bugg-resources/bugg-enclosure/README.md

# bugg-enclosure

This repository contains the FreeCAD source files for the full mechanical assembly of the Bugg recording device. This includes the custom injection moulded inclosure, as well as all connectors, fasteners, etc. used.

For a full overview of the design of the Bugg recording device and practical assembly instructions please refer to the [Bugg hardware handover document](https://raw.githubusercontent.com/bugg-resources/bugg-handover/master/bugg-handover.pdf).

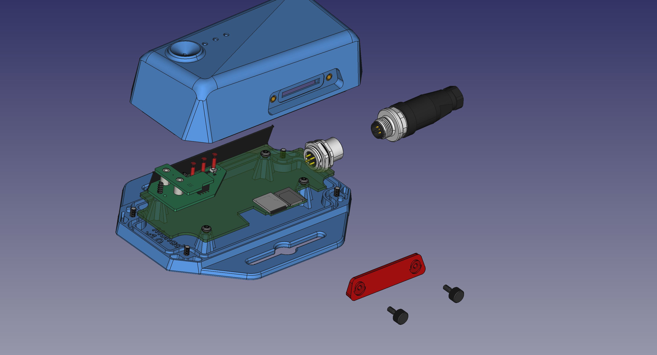
[picture p1: sp-enclosure/cad/exports/1.0/scene-v1.0-2.png]
Bugg exploded view
