bugg-resources/bugg-enclosure/cad/exports/0.15/scene-2.png

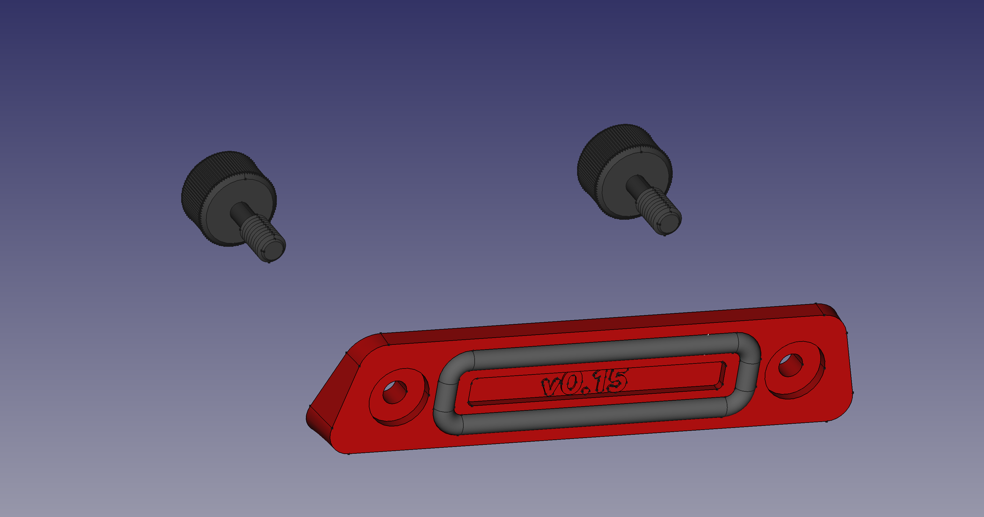
cad/exports/0.15/scene-2.png
