bugg-resources/bugg-enclosure/cad/exports/0.15/scene-3.png

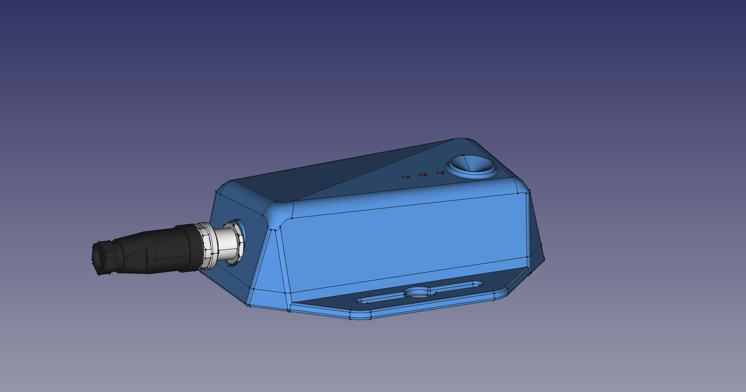
cad/exports/0.15/scene-3.png
