bugg-resources/bugg-enclosure/cad/exports/0.16/scene-1.png

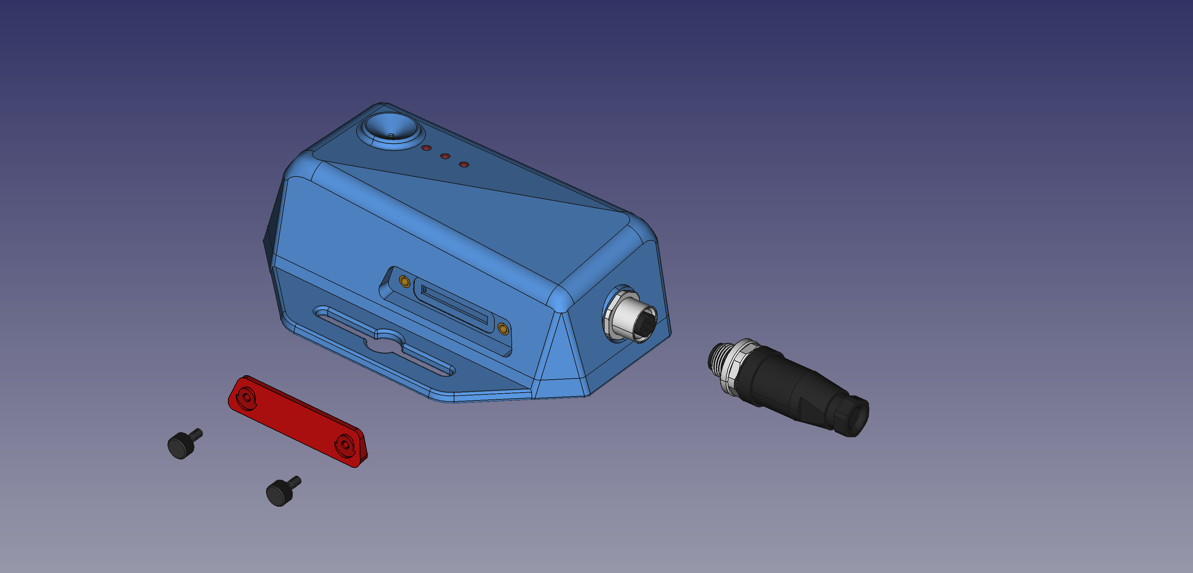
cad/exports/0.16/scene-1.png
