bugg-resources/bugg-enclosure/cad/exports/0.16/scene-2.png

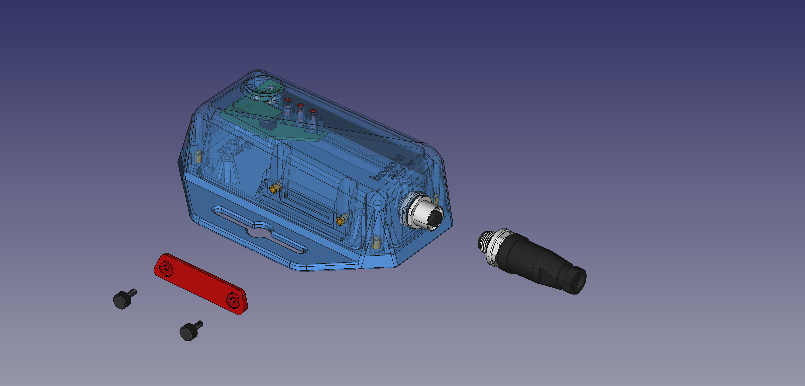
cad/exports/0.16/scene-2.png
