bugg-resources/bugg-enclosure/cad/exports/0.16/scene-3.png

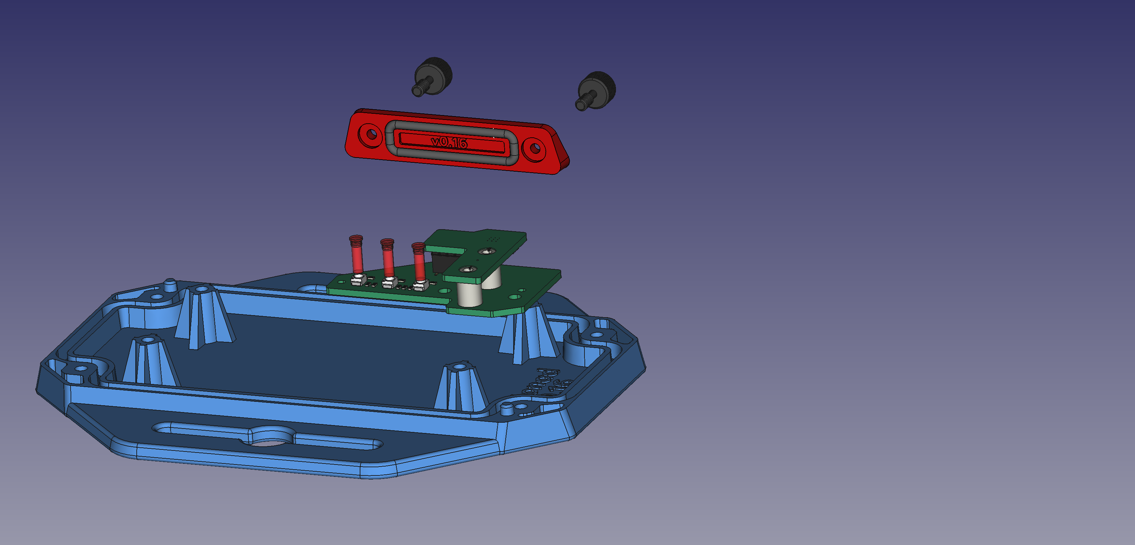
cad/exports/0.16/scene-3.png
