bugg-resources/bugg-enclosure/cad/exports/0.16/scene-4.png

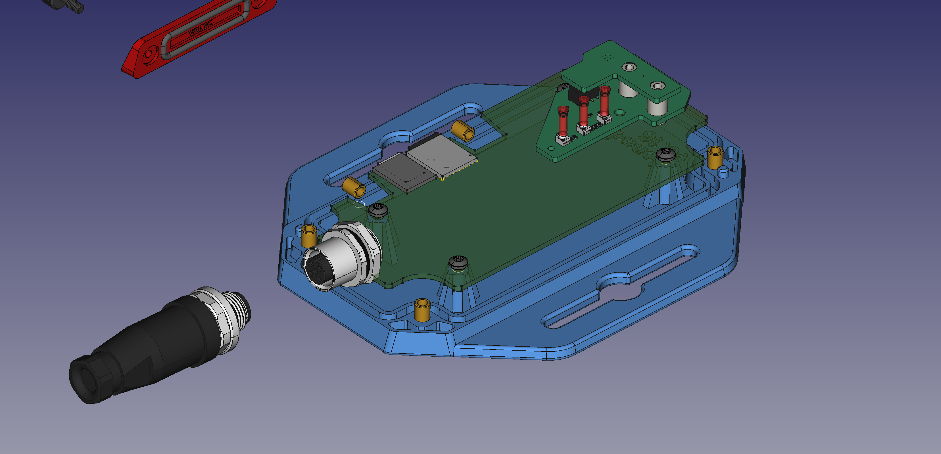
cad/exports/0.16/scene-4.png
