bugg-resources/bugg-enclosure/cad/exports/1.0/scene-v1.0-1.png

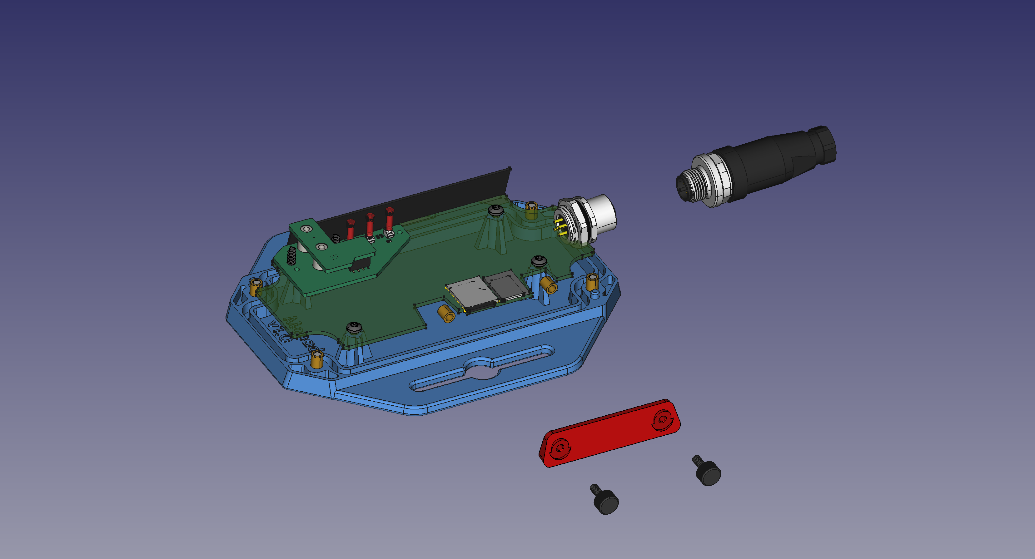
cad/exports/1.0/scene-v1.0-1.png
