bugg-resources/bugg-enclosure/cad/exports/1.2/inspection-difference-v1.0-v1.2.png

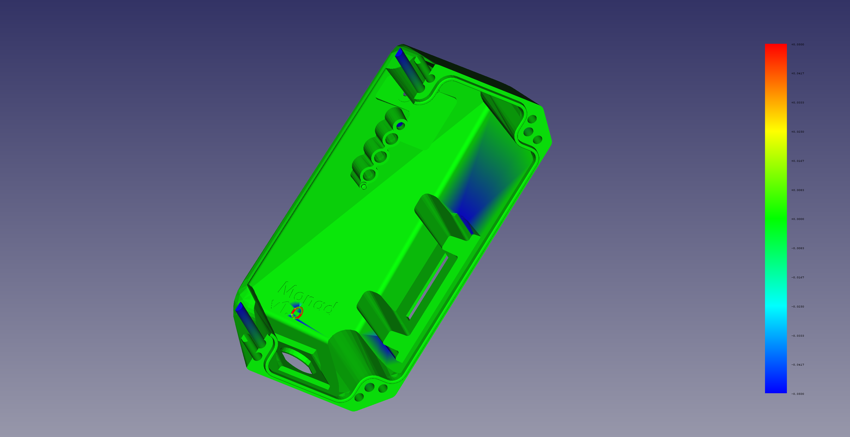
cad/exports/1.2/inspection-difference-v1.0-v1.2.png
