bugg-resources/bugg-enclosure/cad/exports/1.4/inspection-base-corner-closeup.png

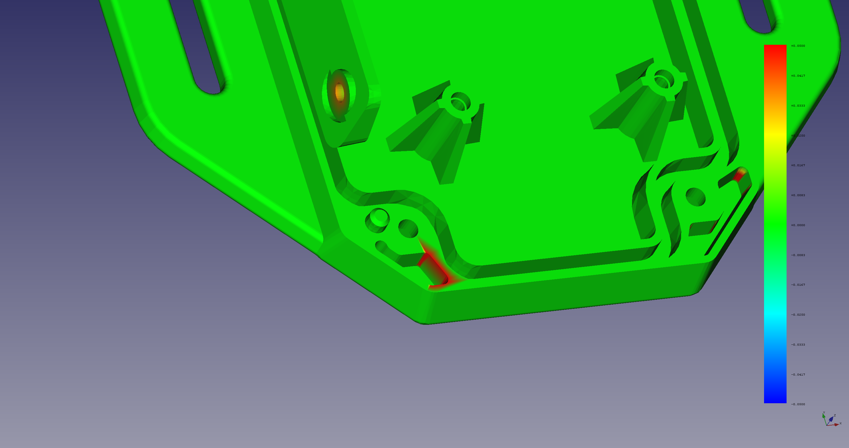
cad/exports/1.4/inspection-base-corner-closeup.png
