bugg-resources/bugg-enclosure/cad/exports/1.4/inspection-base-top-view.png

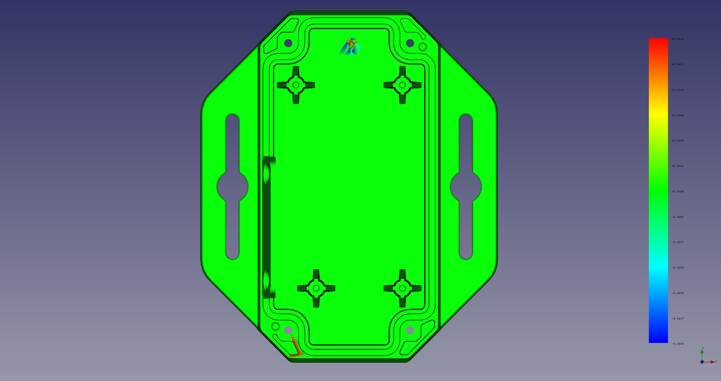
cad/exports/1.4/inspection-base-top-view.png
