bugg-resources/bugg-enclosure/cad/exports/1.4/inspection-lid-inside-view.png

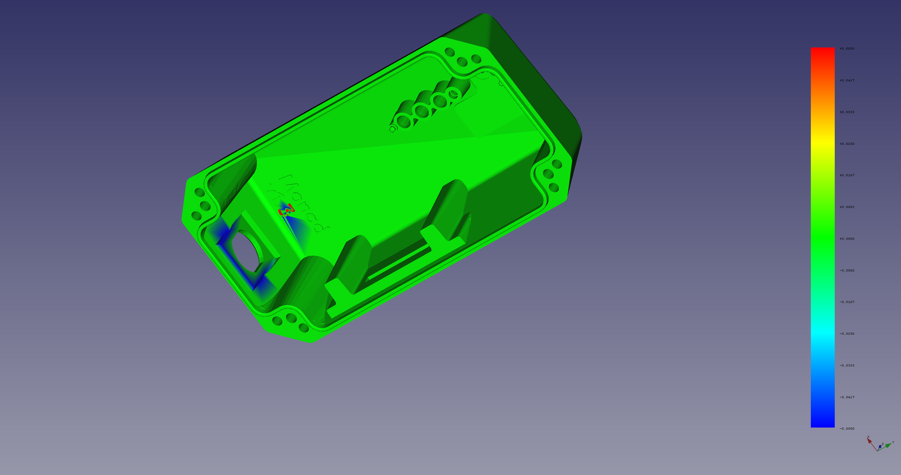
cad/exports/1.4/inspection-lid-inside-view.png
