bugg-resources/bugg-enclosure/cad/exports/1.4/inspection-side-view-closeup.png

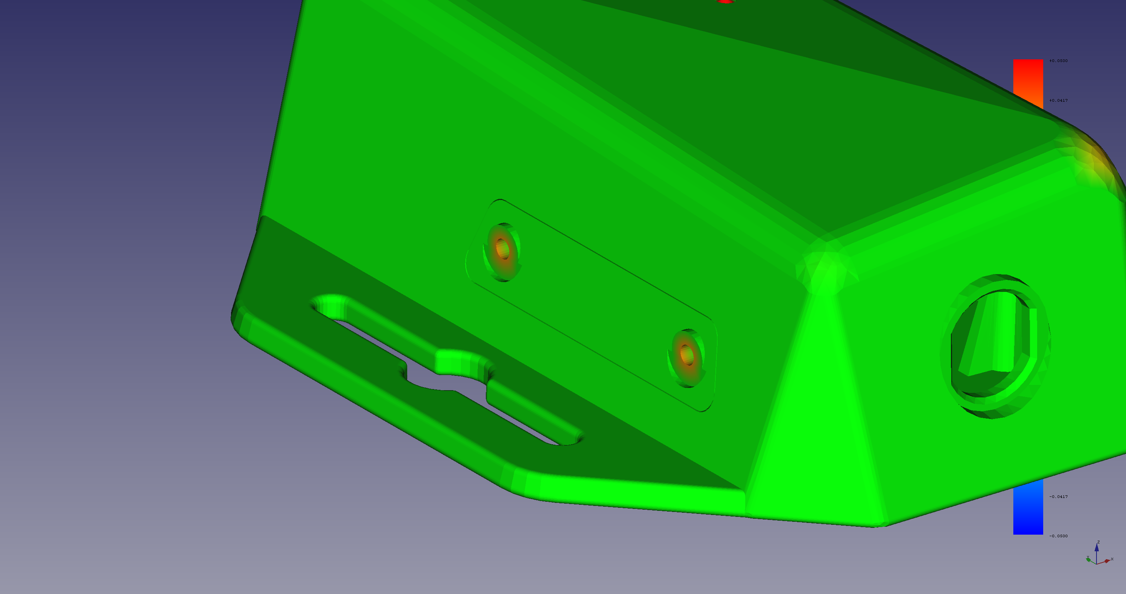
cad/exports/1.4/inspection-side-view-closeup.png
