bugg-resources/bugg-enclosure/cad/exports/1.4/inspection-top-view-closeup.png

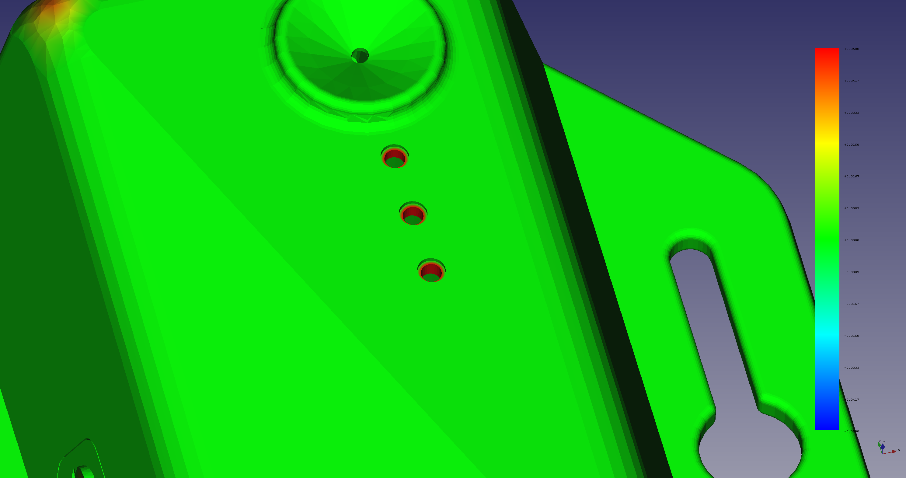
cad/exports/1.4/inspection-top-view-closeup.png
