bugg-resources/bugg-enclosure/cad/exports/1.4/inspection-top-view.png

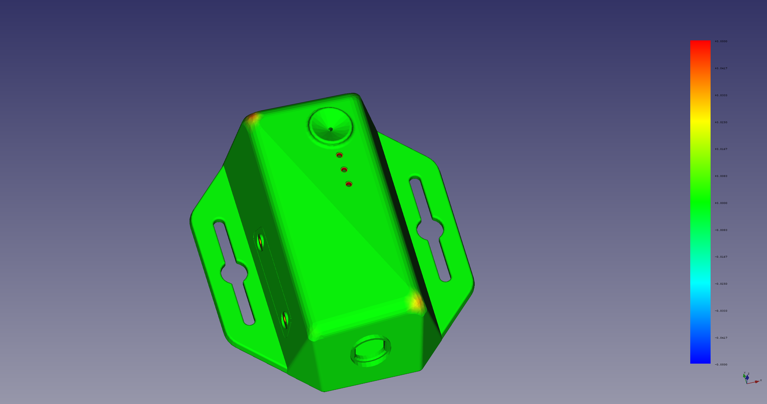
cad/exports/1.4/inspection-top-view.png
