bugg-resources/bugg-enclosure/cad/exports/1.5/enclosure-base-surface-finish-bottom-view.png

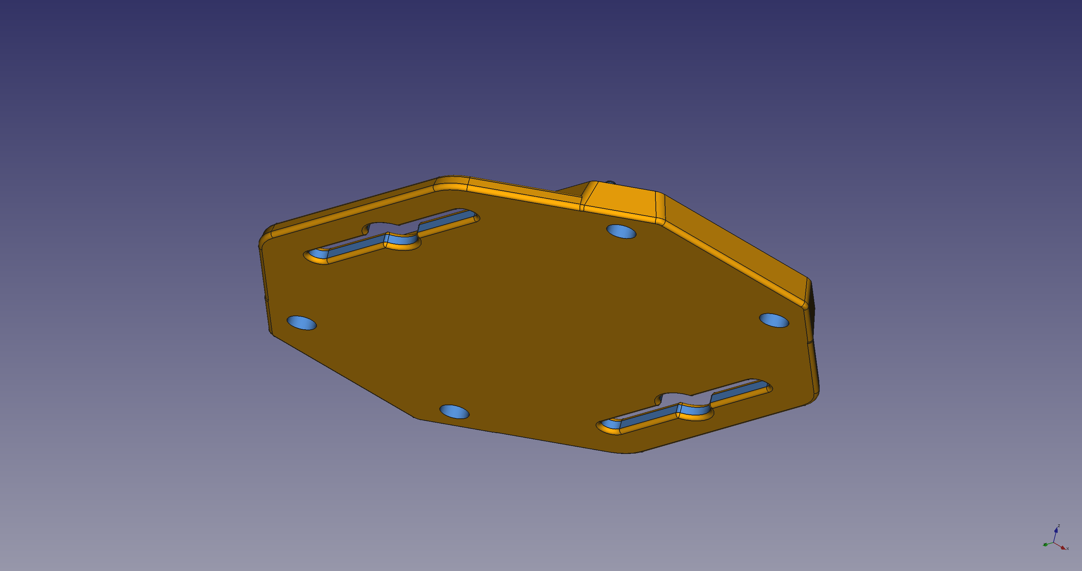
cad/exports/1.5/enclosure-base-surface-finish-bottom-view.png
