bugg-resources/bugg-enclosure/cad/exports/1.5/enclosure-lid-inserts.jpeg

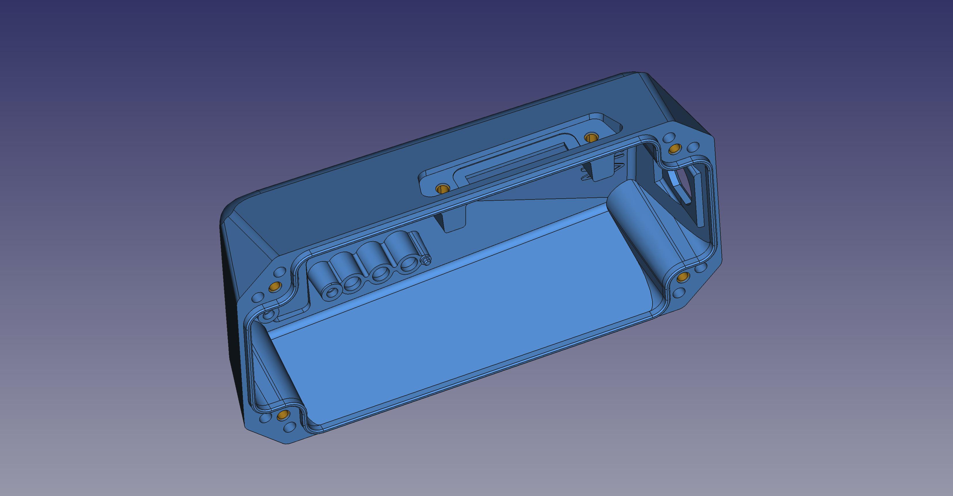
cad/exports/1.5/enclosure-lid-inserts.jpeg
