bugg-resources/bugg-enclosure/cad/exports/FIP/FIPFG-base-groove.png

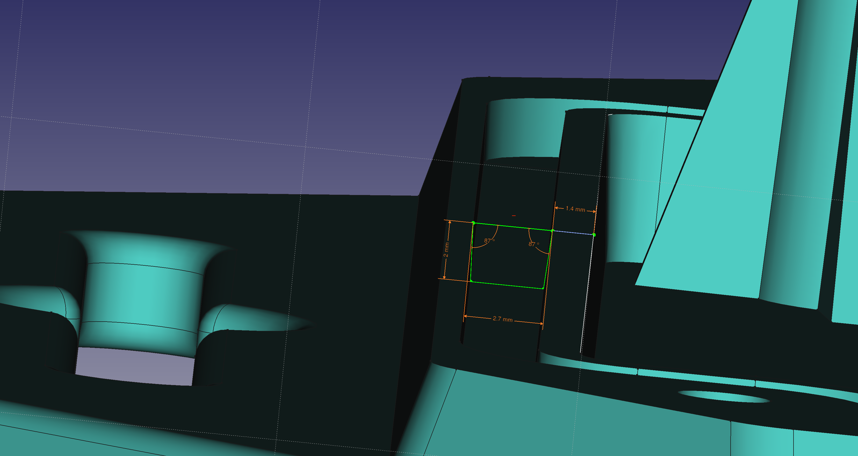
cad/exports/FIP/FIPFG-base-groove.png
