bugg-resources/bugg-enclosure/cad/exports/FIP/FIPFG-door-seated.png

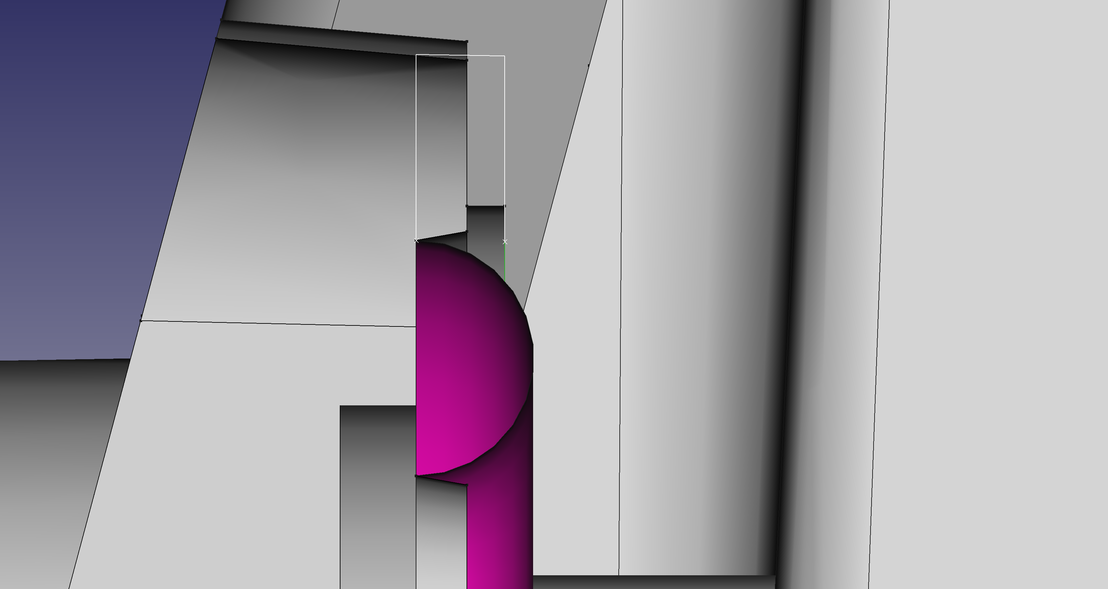
cad/exports/FIP/FIPFG-door-seated.png
