bugg-resources/bugg-enclosure/cad/exports/FIP/FIPFG-door.png

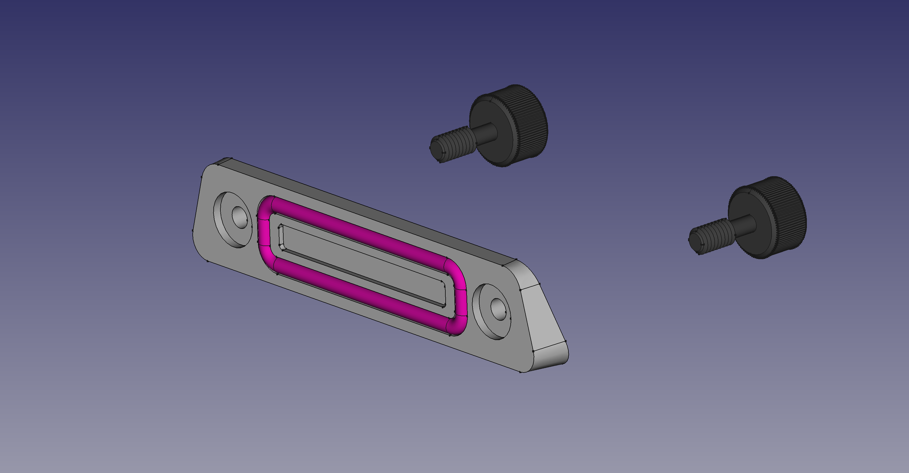
cad/exports/FIP/FIPFG-door.png
