bugg-resources/bugg-enclosure/cad/exports/FIP/FIPFG-lid-seated.png

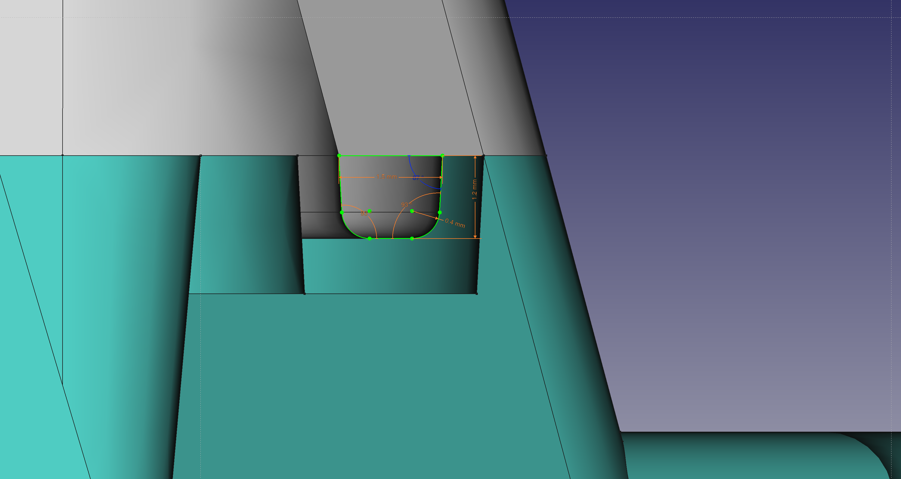
cad/exports/FIP/FIPFG-lid-seated.png
