bugg-resources/bugg-enclosure/cad/exports/FIP/FIPFG-lid-tongue.png

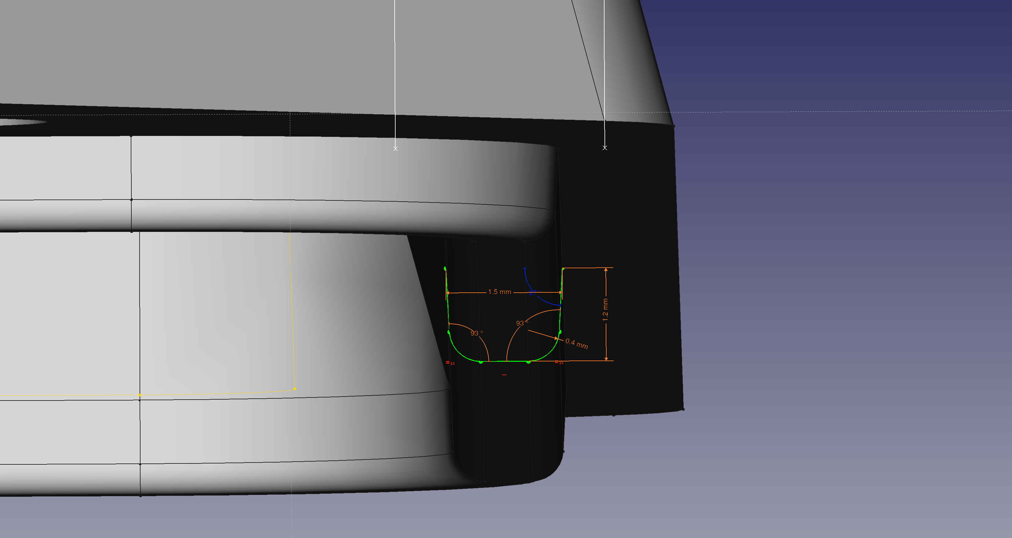
cad/exports/FIP/FIPFG-lid-tongue.png
