bugg-resources/bugg-enclosure/cad/pcba-main.FCStd

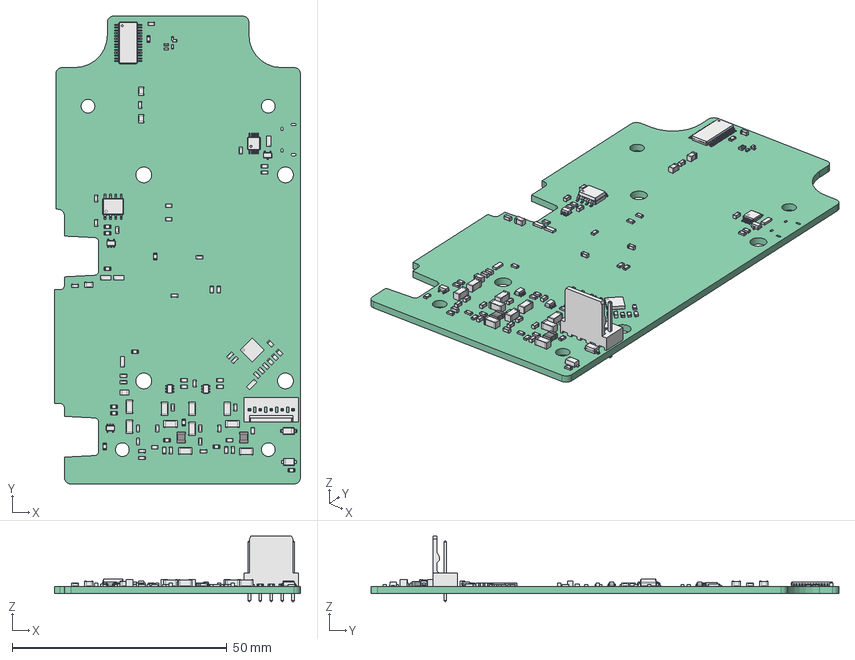
[picture p28: CAD file, 2022-12-02]
cad/pcba-main.FCStd
57.3 x 109.0 x 15.3 mm
Pcb_8c84
C36_C_0603_1608Metric_71721f83c2b1 x 29
C23_C_0805_2012Metric_b6db5c6b0151 x 4
R7_R_0603_1608Metric_90bd1c2a9cc0 x 33
D4_D_SOD_123_dbecf328b756
U13_SOIC_8_39x49mm_P127mm_c0191ea9d7d9
C43_C_1206_3216Metric_21374b62ed42 x 10
Q4_SOT_323_SC_70_d6f08c28aa3d
U8_USON_10_25x10mm_Pitch05mm_80e52ca13184 x 5
R20_R_0402_1005Metric_2000e09633fa x 3
U15_MSOP_10_3x3mm_P05mm_e307f94544ba
U12_QFN-24-1EP_4x4mm_Pitch0.5mm_dd8f22cad111
C20_C_0402_1005Metric_a572c28d08b5 x 2
J10_Molex_AE_6410_05A_f7ff2170b38e
FB1_L_1008_2520Metric_feb8b3634ed0 x 2
U14_SOT_353_SC_70_5_8718e2f7add4 x 2
D5_D_SOD_123F_94f546b71baf
U17_TSSOP_28_44x97mm_P065mm_d82abc36541a
U3_SOT_363_SC_70_6_186d3005d5da x 2
