bugg-resources/bugg-enclosure/cad/exports/0.8/enclosure-assy-v0.8.step

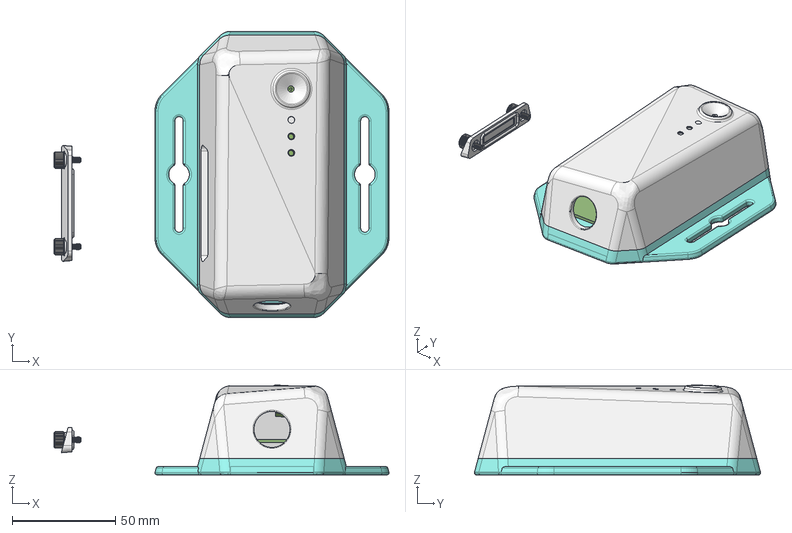
[picture p29: CAD file, 2021-01-20]
cad/exports/0.8/enclosure-assy-v0.8.step
162.3 x 138.7 x 43.5 mm
enclosure-base
enclosure-lid
pcb-main
enclosure-door
antenna-2JP0624P
nanoSIM
SF72-nano-sim-slot
ST11-H
microSD
P0161.030-008-B2
P0161.030-008-B003
pcb-mic
pcb-leds
