bugg-resources/bugg-enclosure/cad/exports/0.10/enclosure-door-v0.10.step

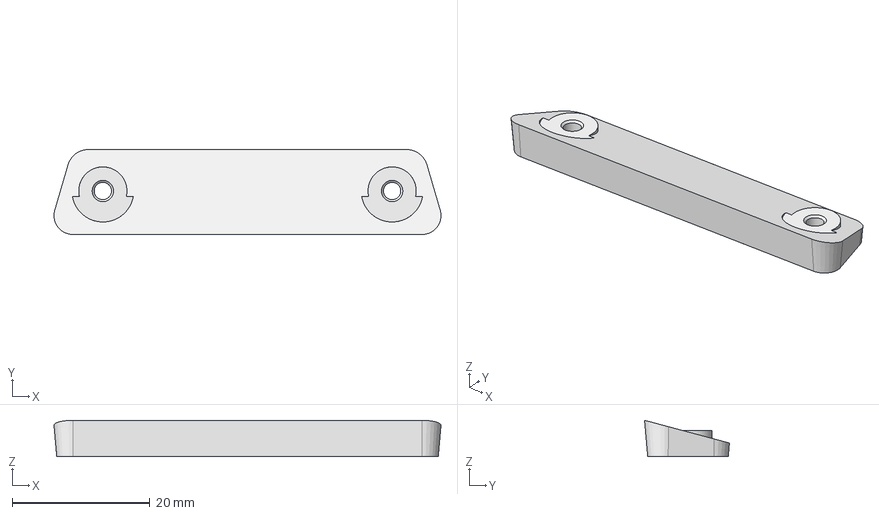
[picture p30: CAD file, 2021-02-13]
cad/exports/0.10/enclosure-door-v0.10.step
56.2 x 12.3 x 5.28 mm
