bugg-resources/bugg-enclosure/cad/exports/0.13.1/enclosure-base-v0.13.1.step

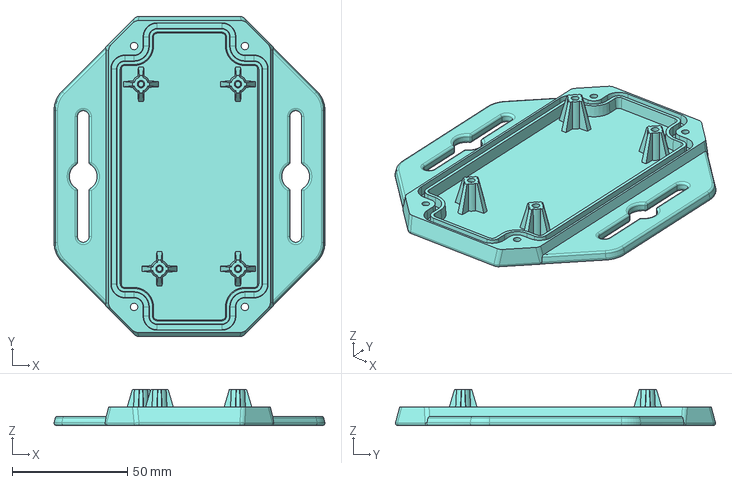
[picture p32: CAD file, 2021-02-22]
cad/exports/0.13.1/enclosure-base-v0.13.1.step
117.4 x 138.7 x 15.6 mm
