bugg-resources/bugg-enclosure/cad/exports/0.15/enclosure-base-v0.15.step

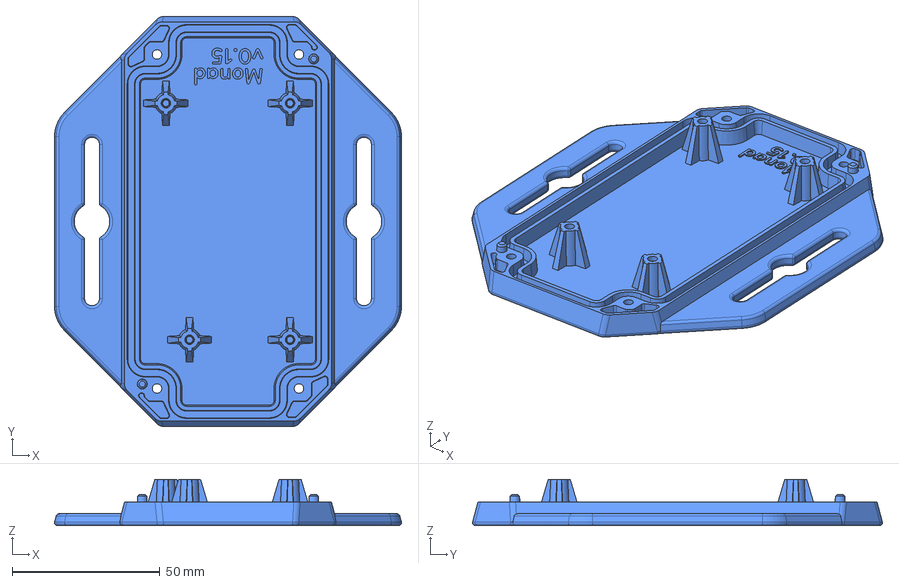
[picture p33: CAD file, 2021-02-24]
cad/exports/0.15/enclosure-base-v0.15.step
117.4 x 138.7 x 15.6 mm
