bugg-resources/bugg-enclosure/cad/exports/0.7/enclosure-door-v0.7.step

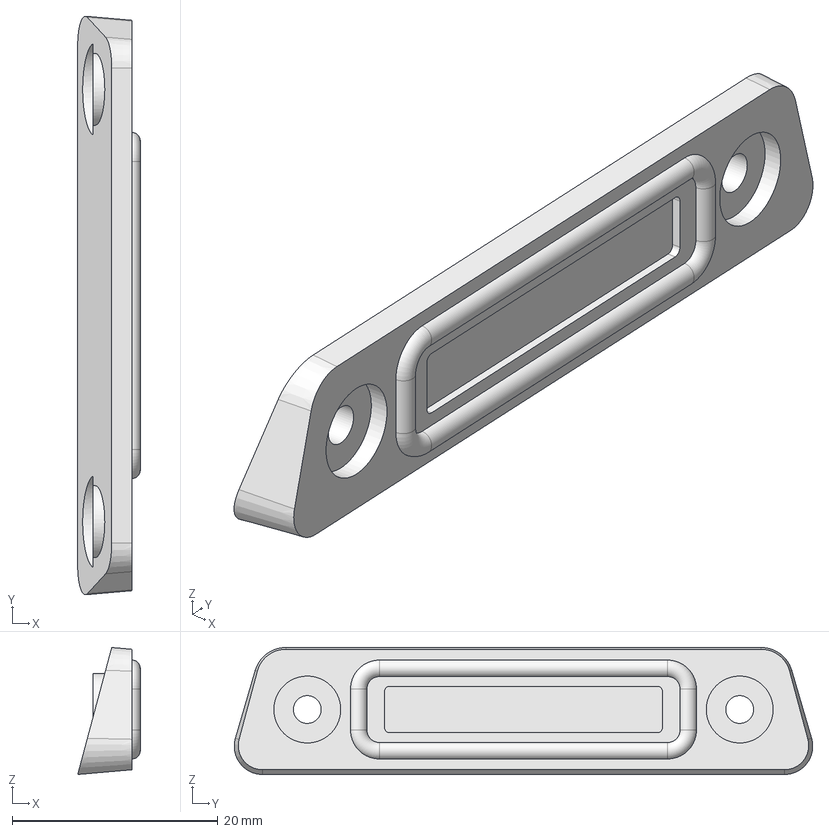
[picture p34: CAD file, 2021-01-20]
cad/exports/0.7/enclosure-door-v0.7.step
6.08 x 56.2 x 12.3 mm
