bugg-resources/bugg-enclosure/cad/exports/1.0/PL_enclosure-lid-v1.0.stp

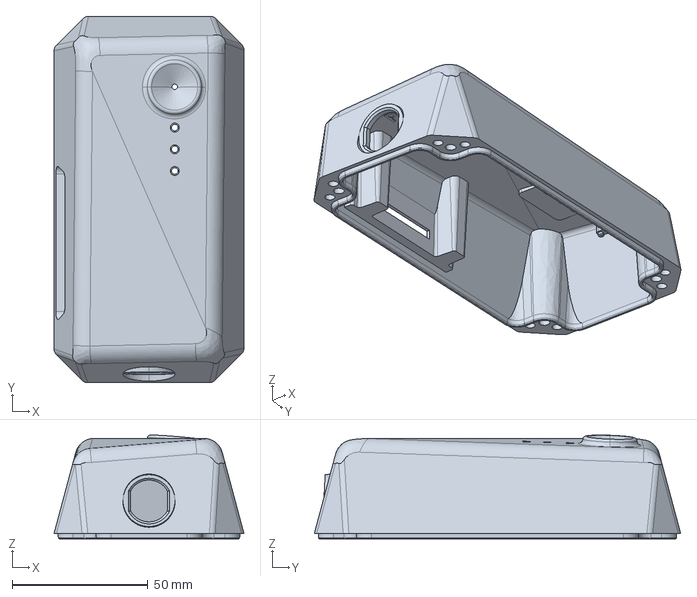
[picture p37: CAD file, 2021-03-11]
cad/exports/1.0/PL_enclosure-lid-v1.0.stp
70.0 x 135.0 x 38.3 mm
