bugg-resources/bugg-enclosure/cad/exports/1.5/insert-tappex-001m3.step

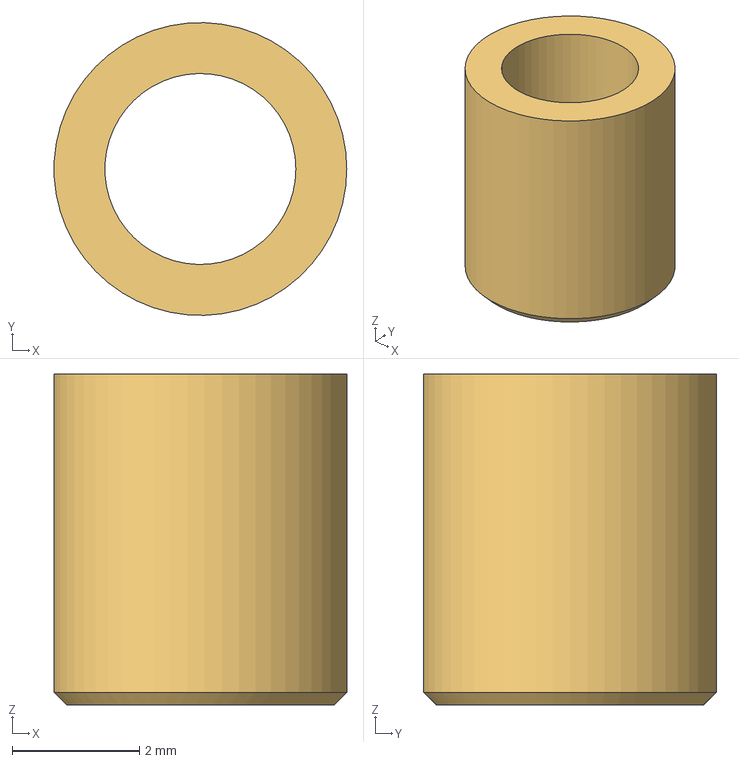
[picture p38: CAD file, 2023-03-03]
cad/exports/1.5/insert-tappex-001m3.step
4.60 x 4.60 x 5.20 mm
