bugg-resources/bugg-enclosure/cad/insert-tappex-002m3.FCStd

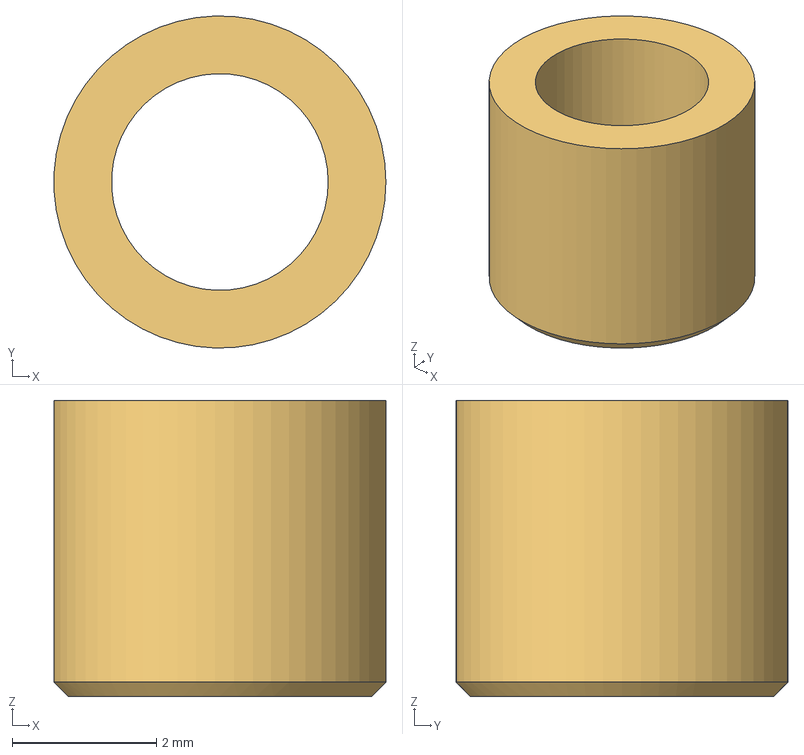
[picture p39: CAD file, 2022-12-02]
cad/insert-tappex-002m3.FCStd
4.60 x 4.60 x 4.10 mm
