bugg-resources/bugg-enclosure/sp-enclosure/cad/enclosure-faceted3.FCStd

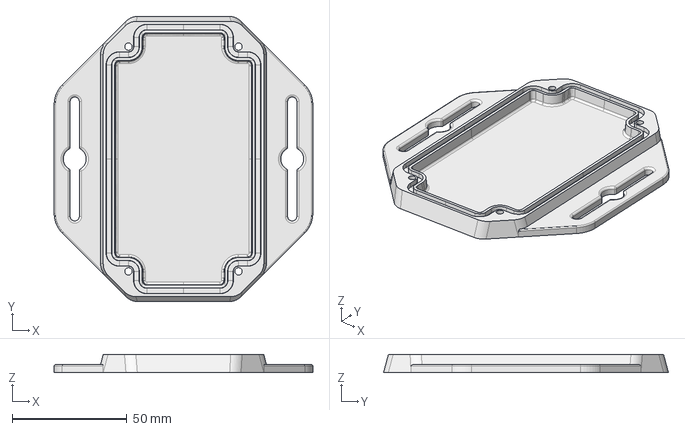
[picture p40: CAD file, 2020-12-04]
sp-enclosure/cad/enclosure-faceted3.FCStd
112.8 x 124.3 x 8.00 mm
