bugg-resources/bugg-enclosure/cad/exports/0.10/enclosure-base-v0.10.step

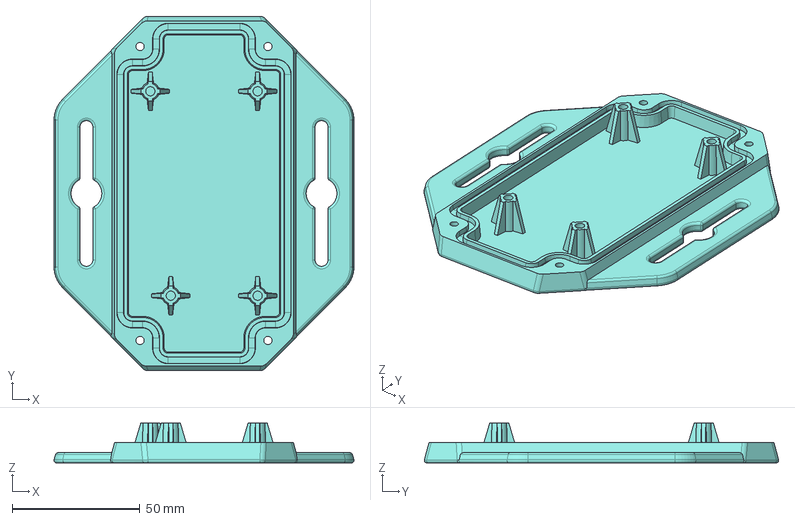
[picture p41: CAD file, 2021-02-13]
cad/exports/0.10/enclosure-base-v0.10.step
117.4 x 138.7 x 15.6 mm
