bugg-resources/bugg-enclosure/cad/exports/0.13/enclosure-lid-with-inserts-v0.13.step

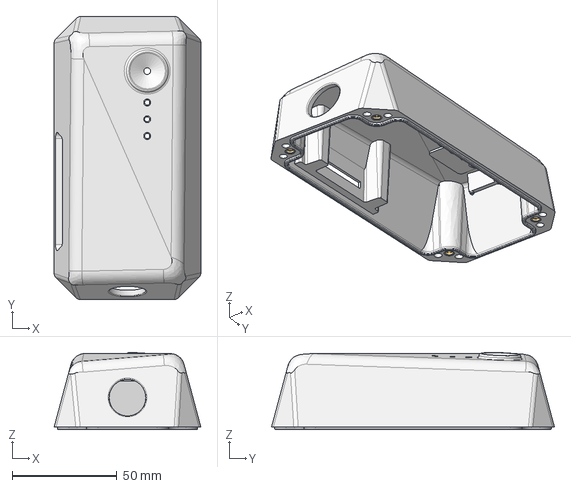
[picture p43: CAD file, 2021-02-22]
cad/exports/0.13/enclosure-lid-with-inserts-v0.13.step
70.0 x 135.0 x 36.8 mm
enclosure-lid
tappex-118m3 x 8
