bugg-resources/bugg-enclosure/cad/exports/0.15/enclosure-door-v0.15.step

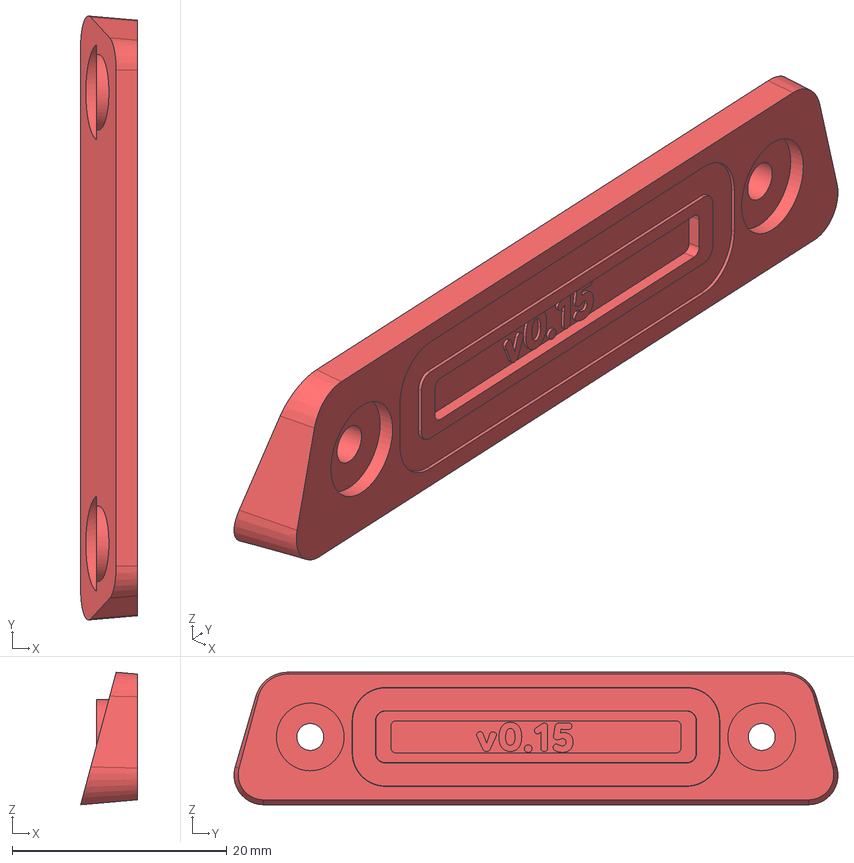
[picture p44: CAD file, 2021-02-24]
cad/exports/0.15/enclosure-door-v0.15.step
5.28 x 56.2 x 12.3 mm
