bugg-resources/bugg-enclosure/cad/exports/0.7/enclosure-base-v0.7.step

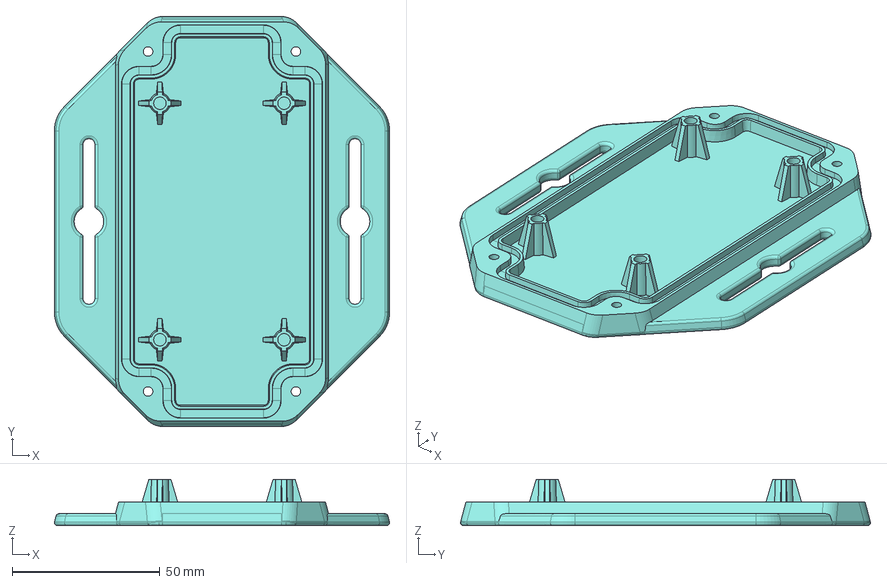
[picture p45: CAD file, 2021-01-20]
cad/exports/0.7/enclosure-base-v0.7.step
113.4 x 138.7 x 15.6 mm
