bugg-resources/bugg-enclosure/cad/exports/1.5/enclosure-lid-v1.5-with-inserts.step

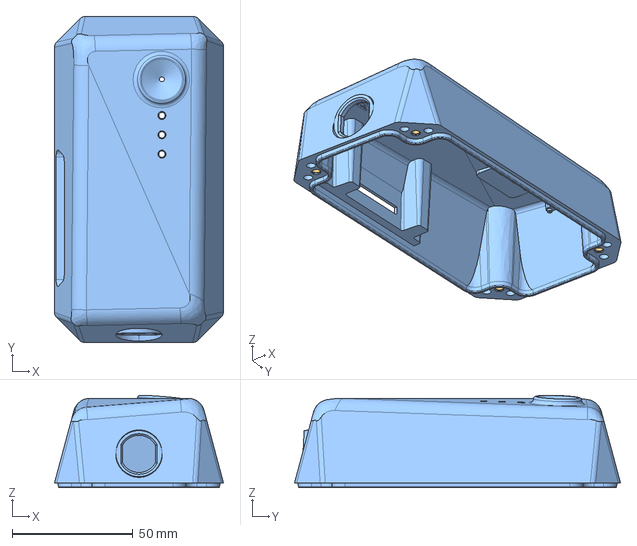
[picture p46: CAD file, 2023-03-03]
cad/exports/1.5/enclosure-lid-v1.5-with-inserts.step
70.0 x 135.0 x 38.3 mm
enclosure-lid
tappex-001m3 x 6
