bugg-resources/bugg-enclosure/cad/te-C-T4111001051-000.FCStd

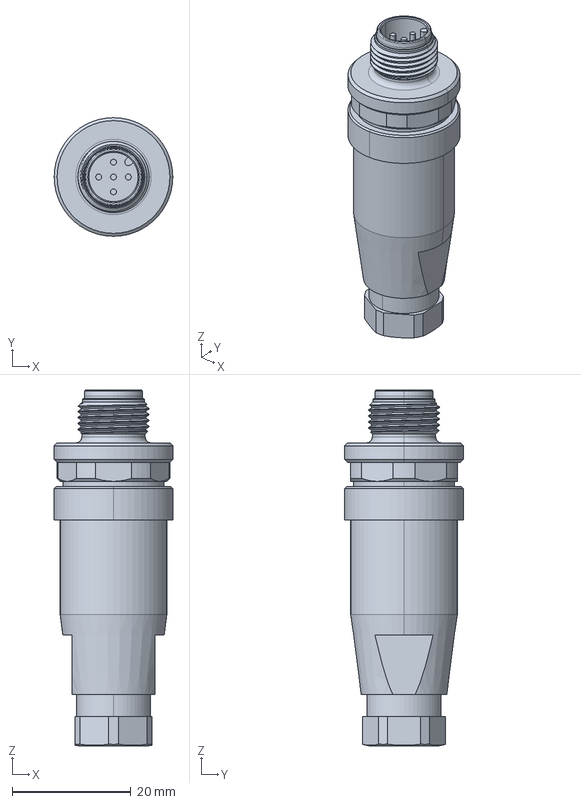
[picture p47: CAD file, 2022-12-02]
cad/te-C-T4111001051-000.FCStd
20.0 x 20.0 x 60.0 mm
