bugg-resources/bugg-enclosure/cad/exports/0.11/enclosure-lid-v0.11.step

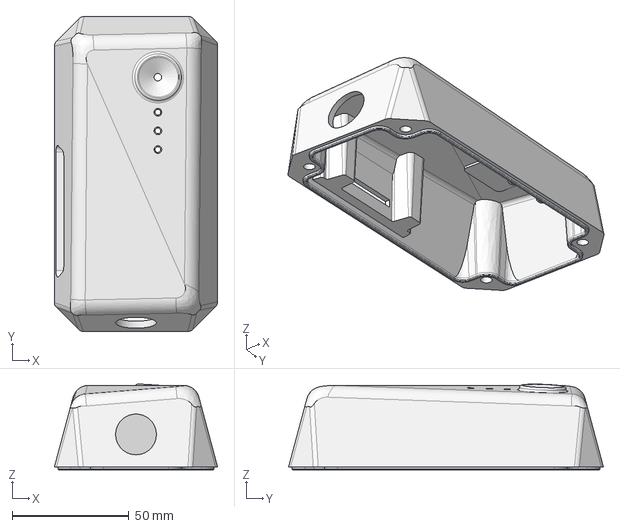
[picture p48: CAD file, 2021-02-15]
cad/exports/0.11/enclosure-lid-v0.11.step
70.0 x 135.0 x 36.8 mm
