bugg-resources/bugg-enclosure/cad/exports/0.12/enclosure-lid-with-inserts-v0.12.step

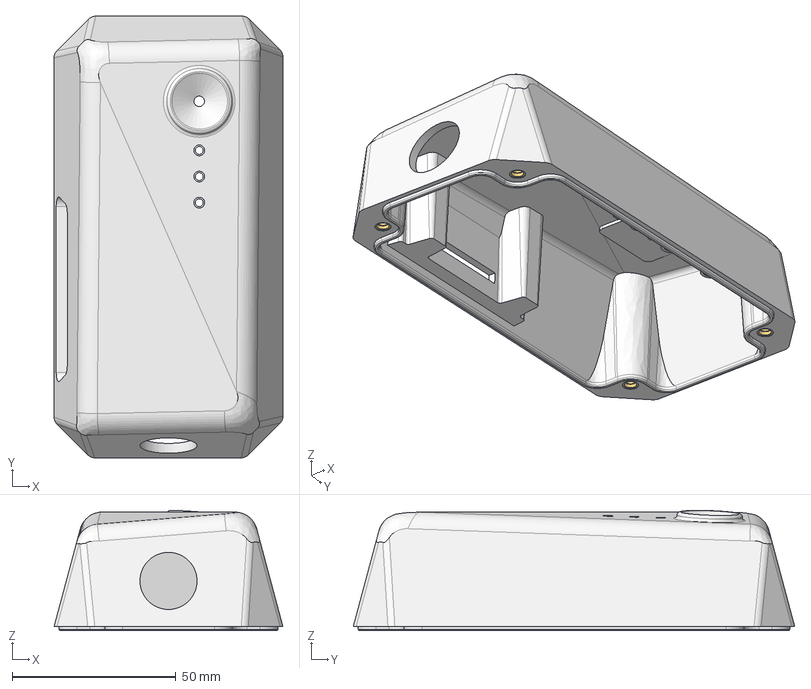
[picture p49: CAD file, 2021-02-22]
cad/exports/0.12/enclosure-lid-with-inserts-v0.12.step
70.0 x 135.0 x 36.8 mm
tappex-118m3 x 8
enclosure-lid
