bugg-resources/bugg-enclosure/cad/exports/0.13/enclosure-lid-v0.13.step

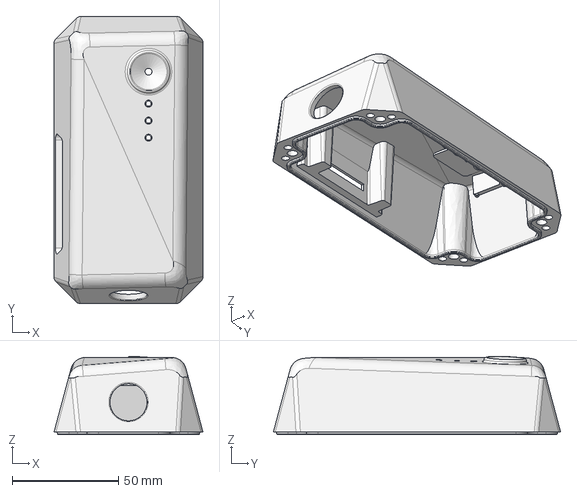
[picture p50: CAD file, 2021-02-22]
cad/exports/0.13/enclosure-lid-v0.13.step
70.0 x 135.0 x 36.8 mm
