bugg-resources/bugg-enclosure/cad/exports/0.12/insert-tappex-118m3.step

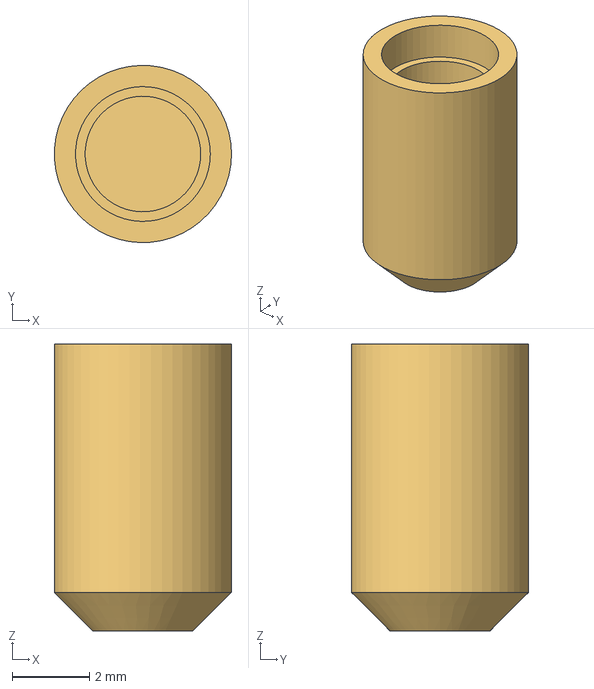
[picture p51: CAD file, 2021-02-22]
cad/exports/0.12/insert-tappex-118m3.step
4.60 x 4.60 x 7.45 mm
