bugg-resources/bugg-enclosure/cad/pcba-led.FCStd

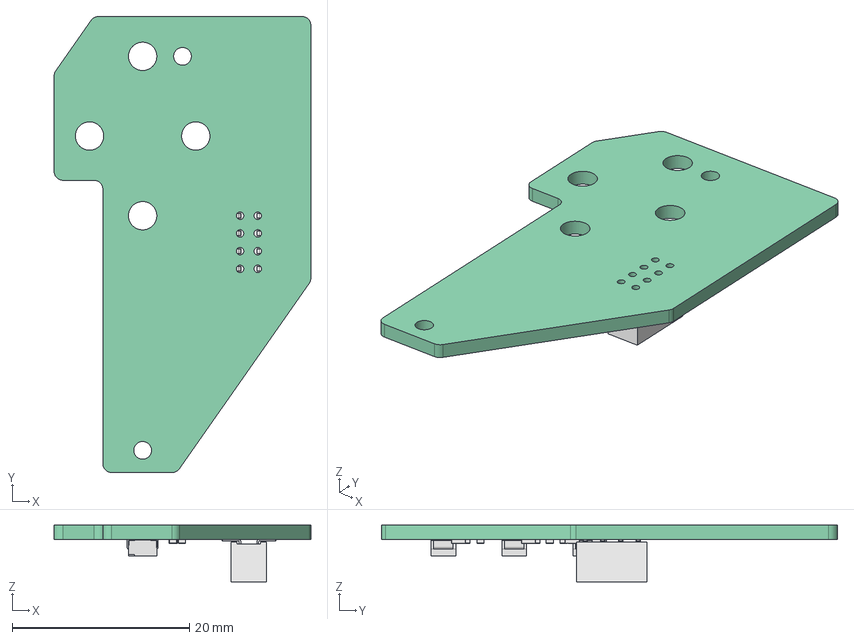
[picture p52: CAD file, 2022-12-02]
cad/pcba-led.FCStd
29.0 x 51.5 x 6.40 mm
Pcb_e137
R6_R_0603_1608Metric_1a6a01549eb1 x 9
LED3_AA3528_abf163f14b28 x 3
J1_PinSocket_2x04_P200mm_Vertical_SMD_f3e8250f079b
