bugg-resources/bugg-enclosure/cad/pcba-mic.FCStd

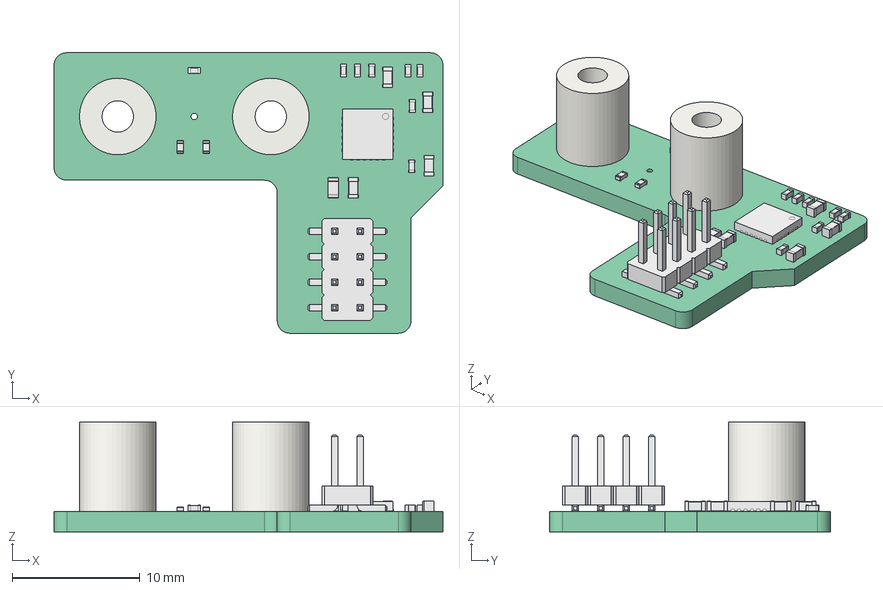
[picture p53: CAD file, 2022-12-02]
cad/pcba-mic.FCStd
30.5 x 22.0 x 8.60 mm
Pcb_7e91
"C3"_C_0402_1005Metric_047c33d6-59ee-497e-bc12-8dedc0a7de93 x 8
"C4"_C_0603_1608Metric_0b8f16c8-f2b0-4d91-b9cc-b8230c3aa445 x 4
REF_Mounting_Wuerth_WA_SMSI_M3_H7mm_9774070360_4d565f57-3fd4-4d7f-a228-072ec44917a8 x 2
"R2"_R_0402_1005Metric_662c17e7-7638-49a5-958f-a5fe974198cc x 2
"J1"_PinHeader_2x04_P200mm_Vertical_SMD_700992b7-0c28-4924-96fc-d2858487aac2
"U1"_QFN-24-1EP_4x4mm_Pitch0.5mm_837daa91-3569-4ff0-b422-76c7df1d7d7b[2]
"R3"_R_0603_1608Metric_e25241e2-804b-429e-a8a2-7c1b0d21afb0
