bugg-resources/bugg-enclosure/cad/te-C-T4171310005-001.FCStd

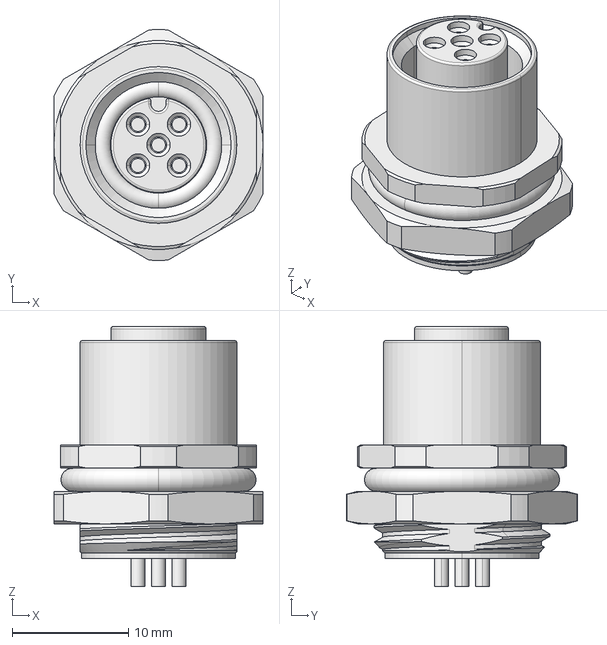
[picture p54: CAD file, 2022-12-02]
cad/te-C-T4171310005-001.FCStd
18.0 x 19.9 x 22.4 mm
