bugg-resources/bugg-enclosure/cad/dimensional-inspection.FCStd

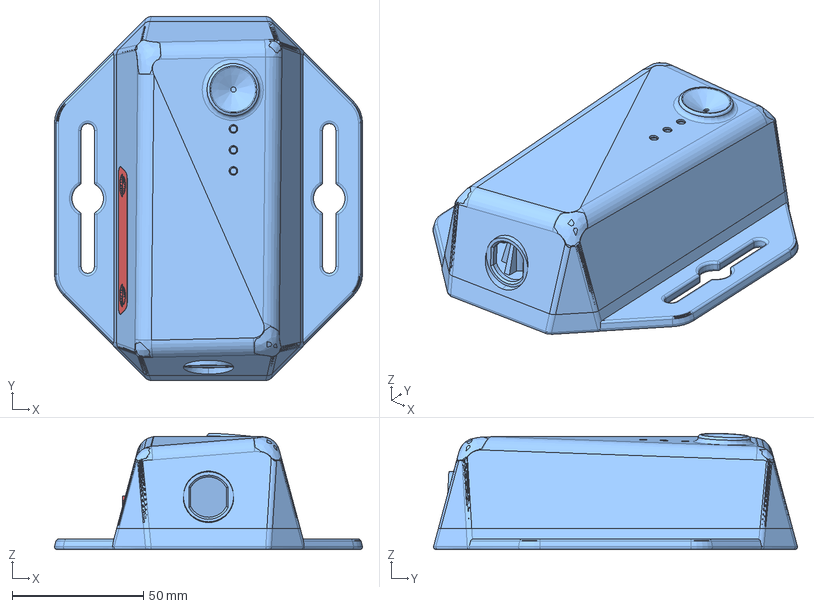
[picture p55: CAD file, 2022-06-28]
cad/dimensional-inspection.FCStd
117.4 x 138.7 x 44.3 mm
enclosure-lid-1.3-step
enclosure-base-1.4.step
enclosure-base-1.0.step
enclosure-door-1.4.step
enclosure-door-1.0.step
enclosure-lid-1.5.step
