bugg-resources/bugg-enclosure/cad/lightpipe-mentor-1282_1501.FCStd

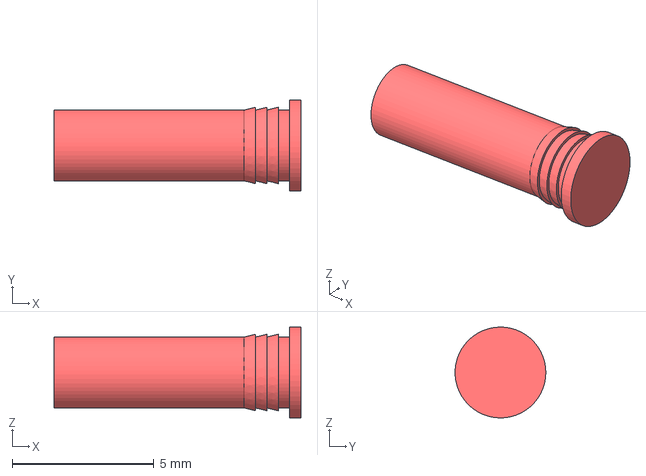
[picture p56: CAD file, 2022-06-27]
cad/lightpipe-mentor-1282_1501.FCStd
8.70 x 3.20 x 3.20 mm
