bugg-resources/bugg-enclosure/cad/pcb-mic.FCStd

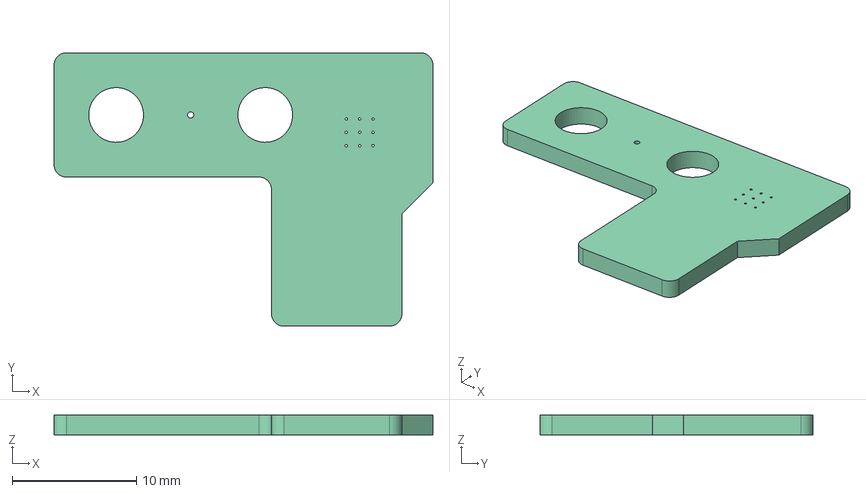
[picture p57: CAD file, 2021-08-03]
cad/pcb-mic.FCStd
30.5 x 22.0 x 1.60 mm
