bugg-resources/bugg-enclosure/cad/TR Fastenings Ltd-3mmX8mm.STEP

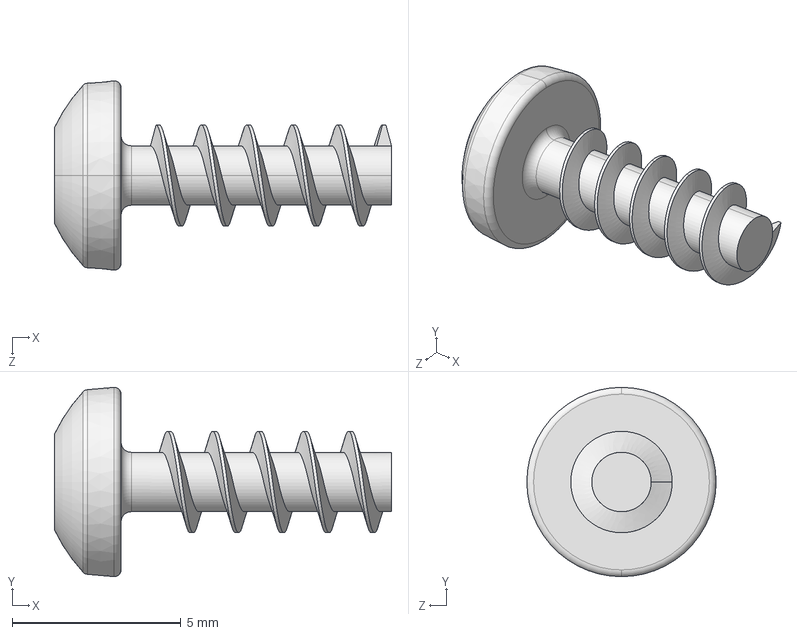
[picture p58: CAD file, 2021-08-03]
cad/TR Fastenings Ltd-3mmX8mm.STEP
9.97 x 5.60 x 5.60 mm
