bugg-resources/bugg-enclosure/cad/antenna-2JP0424.FCStd

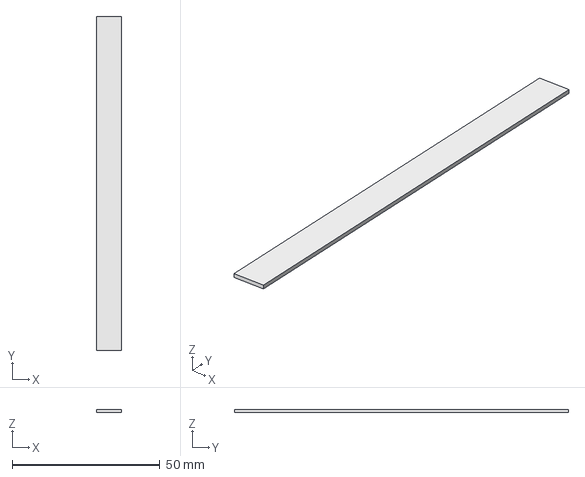
[picture p59: CAD file, 2021-02-13]
cad/antenna-2JP0424.FCStd
8.50 x 113.0 x 1.00 mm
