bugg-resources/bugg-enclosure/cad/P0161.030-008-B2.step

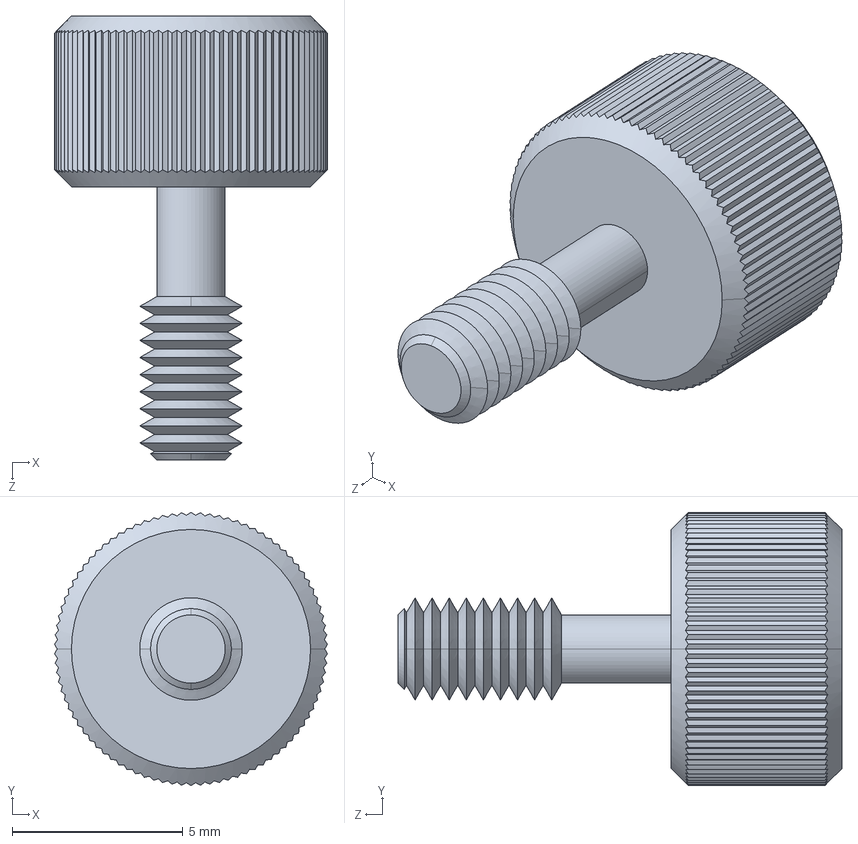
[picture p60: CAD file, 2021-02-13]
cad/P0161.030-008-B2.step
8.00 x 8.00 x 13.0 mm
