bugg-resources/bugg-enclosure/(list of files, cad)

Other CAD files:
cad/exports/0.11/enclosure-door-v0.11.step
cad/exports/0.13/enclosure-door-v0.13.step
cad/exports/0.14/enclosure-base-v0.14.step
cad/exports/0.16/enclosure-base-v0.16.step
cad/exports/0.8/enclosure-door-v0.8.step
cad/exports/1.1/enclosure-base-v1.1.step
cad/exports/1.2/enclosure-base-v1.2.step
cad/exports/1.3/enclosure-lid-v1.3.step
cad/exports/1.4/enclosure-base-v1.4.step
cad/exports/0.11/enclosure-base-v0.11.step
cad/exports/0.13.1/enclosure-door-v0.13.1.step
cad/exports/0.14/enclosure-lid-v0.14.step
cad/exports/0.16/PL_enclosure-lid-v0.16.stp
cad/exports/0.8/enclosure-base-v0.8.step
cad/exports/0.9.1/enclosure-door-v0.9.1.step
cad/exports/0.9/enclosure-door-v0.9.step
cad/exports/1.0/enclosure-base-v1.0.step
cad/exports/1.1/enclosure-door-v1.1.step
cad/exports/1.2/enclosure-lid-v1.2.step
cad/exports/1.4/enclosure-door-v1.4.step
cad/exports/0.10/enclosure-lid-v0.10.step
cad/exports/0.13.1/enclosure-lid-v0.13.1.step
cad/exports/0.14/enclosure-door-v0.14.step
cad/exports/0.15/enclosure-lid-v0.15.step
cad/exports/0.16/enclosure-door-v0.16.step
cad/exports/0.7/enclosure-lid-v0.7.step
cad/exports/0.8/enclosure-lid-v0.8.step
cad/exports/0.9.1/enclosure-lid-v0.9.1.step
cad/exports/0.9/enclosure-base-v0.9.step
cad/exports/1.0/enclosure-door-v1.0.step
cad/exports/1.1/enclosure-lid-v1.1.step
cad/exports/1.2/enclosure-door-v1.2.step
cad/exports/1.4/enclosure-lid-v1.4.step
cad/exports/1.5/enclosure-base-v1.5.step
cad/exports/0.13.1/enclosure-lid-with-inserts-v0.13.1.step
cad/exports/0.13/enclosure-base-with-inserts-v0.13.step
cad/exports/0.16/enclosure-lid-v0.16.step
cad/exports/1.0/PL_enclosure-base-v1.0.stp
cad/exports/1.5/enclosure-lid-v1.5.step
cad/exports/0.12/enclosure-base-with-inserts-v0.12.step
cad/exports/0.13/enclosure-base-v0.13.step
cad/exports/1.0/enclosure-lid-v1.0.step
cad/exports/1.5/enclosure-door-v1.5.step
cad/exports/0.12/enclosure-door-v0.12.step
cad/exports/0.13/insert-118m3.step
cad/exports/1.0/PL_enclosure-door-v1.0.stl
cad/exports/0.12/enclosure-base-v0.12.step
cad/exports/0.12/enclosure-lid-v0.12.step
cad/insert-tappex-001m3.FCStd
cad/c-t4111001051-000-a-3d-colours.stp
cad/c-t4171310005-001-a-3d-colours.stp
cad/exports/0.10/enclosure-door-v0.10.stl
cad/exports/0.11/enclosure-door-v0.11.stl
cad/exports/0.12/enclosure-door-v0.12.stl
cad/exports/0.13/enclosure-door-v0.13.stl
cad/exports/0.14/enclosure-door-v0.14.stl
cad/exports/0.15/enclosure-door-v0.15.stl
cad/exports/0.16/enclosure-door-v0.16.stl
cad/exports/0.16/enclosure-lid-v0.16.dxf
cad/exports/0.7/enclosure-door-v0.7.stl
cad/exports/0.8/enclosure-door-v0.8.stl
cad/exports/0.9/enclosure-door-v0.9.stl
cad/exports/1.0/enclosure-door-v1.0.stl
cad/screw-plastech30-3x8-TR00032288.FCStd
