bugg-resources/bugg-enclosure/pad-print/bugg-labeling-v3.1.pdf

## Centerline to nanoSIM

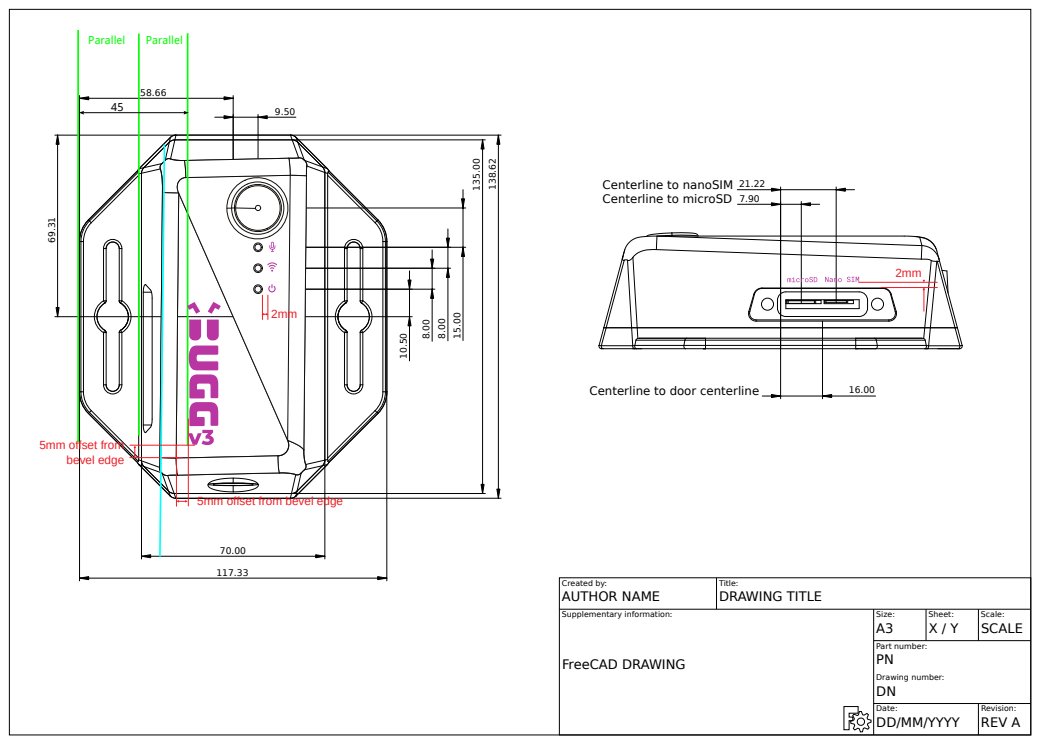
[picture p61: page 1]
Created by:; Title:; Supplementary information:; Size:; Sheet:; Scale:; Part number:; Drawing number:; Date:; Revision:; AUTHOR NAME; DRAWING TITLE; FreeCAD DRAWING; SCALE; DD/MM/YYYY; REV A; 5mm offset from bevel edge; Parallel

Centerline to microSD

Centerline to door centerline

5mm offset from bevel edge
