bugg-resources/bugg-enclosure/pad-print/bugg-labeling-side-wall-v2.pdf

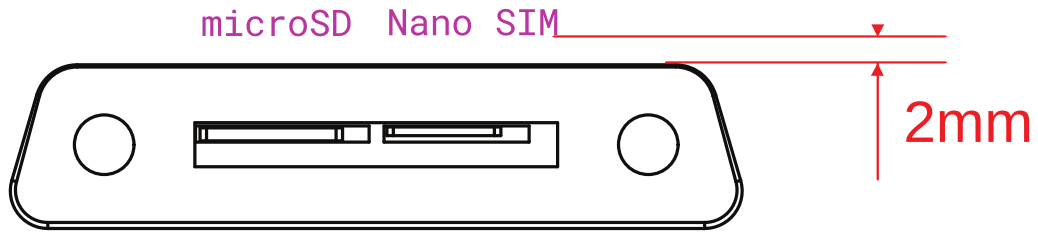
[picture p62: page 1]
