bugg-resources/bugg-enclosure/pad-print/enclosure-assy-v1.0.pdf

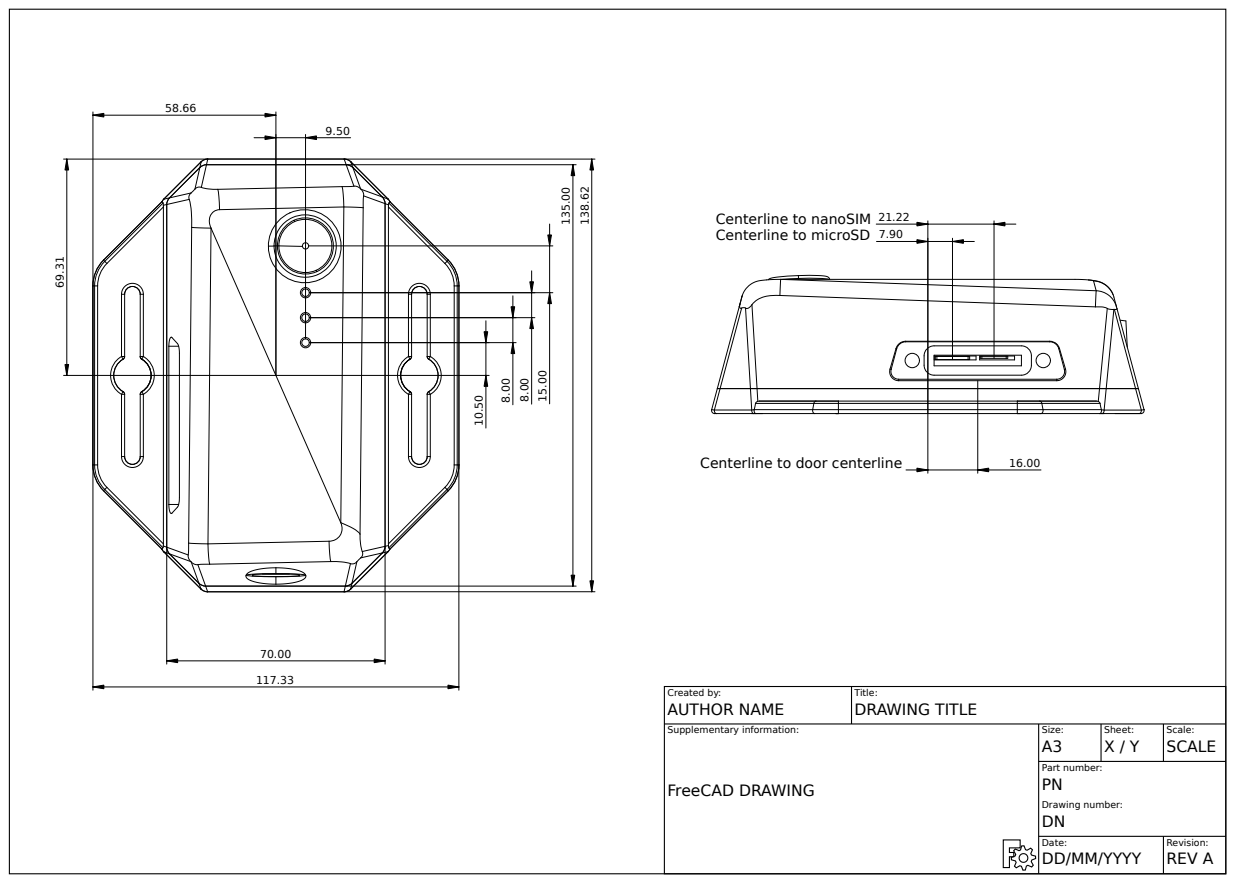
[picture p63: page 1]
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

Centerline to nanoSIM
Centerline to microSD

Centerline to door centerline
