bugg-resources/bugg-enclosure/pad-print/bugg-labeling-v1.0.pdf

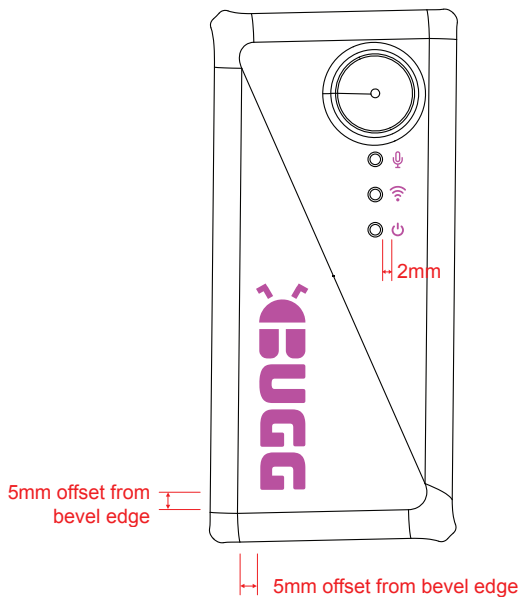
[picture p64: page 1]
5mm offset from bevel edge

5mm offset from bevel edge

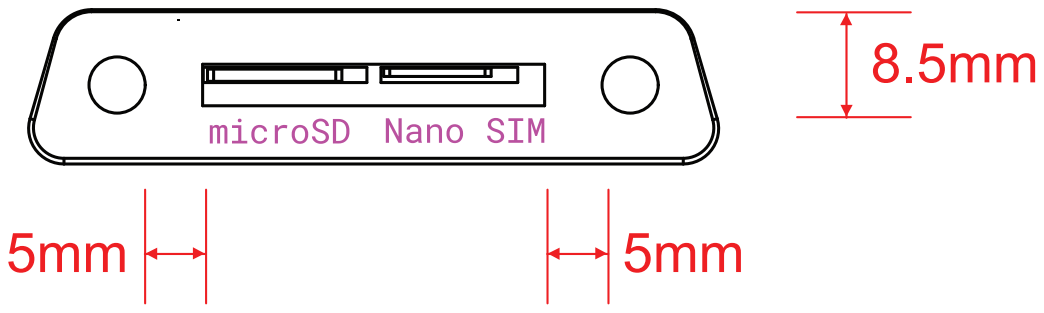
[picture p65: page 2]
