bugg-resources/bugg-enclosure/(commit log)

2020-11-18 First crack at the board footprint
2020-11-18 Basic lofts in place - shape of box defined
    [enclosure-base.FCStd]
2020-11-19 Added wings, reduced total height
    [enclosure-base.FCStd]
2020-11-19 Add pcb footprint sketch
2020-11-19 Create boolean merge for STL output
    [enclosure-base.FCStd]
2020-11-25 Create geometry for lid
    [enclosure-base.FCStd]
2020-11-26 Ditched surface modelling attempt. Just disovered the Draft operator, which is really helping. Now have a parametric drafted trapezium, which is a good start
    [enclosure-base.FCStd]
2020-11-26 New attempt at the faceted enclosure design - using Draft and SliceApart operators. Walls and bottom corners in place
    [enclosure-faceted.FCStd]
2020-11-26 Roof pitch cut
    [enclosure-faceted.FCStd]
2020-11-26 Organise work tree, group cuts and planes
    [enclosure-faceted.FCStd]
2020-11-26 Really nice combination of SliceToCompound and CompoundFilter to yield basic finished box shape
    [enclosure-faceted.FCStd]
2020-11-26 Create a new body based on the output of the CF so we can apply new operations on it - e.g. fillets, without it bitching.
    [enclosure-faceted.FCStd]
2020-11-27 Add parametric fillets
    [enclosure-faceted.FCStd]
2020-11-27 Add split plane
    [enclosure-faceted.FCStd]
2020-11-27 Shell out the lid, add internal fillets
    [enclosure-faceted.FCStd]
2020-11-27 Jesus that was hard. Created screw bosses
    [enclosure-faceted.FCStd]
2020-11-27 Fixed CompoundFilter by limiting boss height using parametric height calculation
    [enclosure-faceted.FCStd]
2020-11-28 New attempt, with careful history checking, Topological Naming problem mitigation, and, maybe, use of cutting tool for boolean removal of insides, rather than using Thickness operator
    [enclosure-faceted3.FCStd]
2020-11-29 X draft with subtractive pipe
    [enclosure-faceted3.FCStd]
2020-11-29 Y draft with subtractive pipe
    [enclosure-faceted3.FCStd]
2020-11-29 Roof pitch in place. Tested changing some parameters - everything looks stable
    [enclosure-faceted3.FCStd]
2020-11-29 Drafts complete on cutting tool
    [enclosure-faceted3.FCStd]
2020-11-29 Roof pitch complete on cutting tool
    [enclosure-faceted3.FCStd]
2020-11-29 First corner cut
    [enclosure-faceted3.FCStd]
2020-11-29 Second corner cut
    [enclosure-faceted3.FCStd]
2020-11-29 Third corner cut
    [enclosure-faceted3.FCStd]
2020-11-29 Fourth corner cut
    [enclosure-faceted3.FCStd]
2020-11-29 Fix corner angle calculations
    [enclosure-faceted3.FCStd]
2020-11-29 Cutting tool corner 1 cut
    [enclosure-faceted3.FCStd]
2020-11-29 Cutting tool corner 2 cut
    [enclosure-faceted3.FCStd]
2020-11-29 Cutting tool corner 4 cut
    [enclosure-faceted3.FCStd]
2020-11-29 Change some parameters
    [enclosure-faceted3.FCStd]
2020-11-29 Boss proof of concept
    [enclosure-faceted3.FCStd]
2020-11-30 Boss in one corner
    [enclosure-faceted3.FCStd]
2020-11-30 Rewound some hairy broken geometry related to mirroring the corner bosses
    [enclosure-faceted3.FCStd]
2020-12-01 All corner bosses properly in place. Had to rebuild the mirrored sketches by hand. Sketch->Mirror sketch doesn't copy constraints! FFS!!!!
    [enclosure-faceted3.FCStd]
2020-12-01 Remove all radii from the cutting tool, rebuild corner sub lofts with cleaner geometry, use amazing MultiTransform tool to mirror the feature - no more manually constructed mirrored sketches
    [enclosure-faceted3.FCStd]
2020-12-01 Added fillets to blend bosses into walls. Very nice result - much cleaner 3D geometry
    [enclosure-faceted3.FCStd]
2020-12-01 Added sealing feature
    [enclosure-faceted3.FCStd]
2020-12-01 Added holes for threaded insert s
    [enclosure-faceted3.FCStd]
2020-12-01 Add flange mount MIL connetor
    [connector-mil-pt07a.FCStd]
2020-12-01 Rebuild bayonet pins
    [connector-mil-pt07a.FCStd]
2020-12-01 Add nut. Combine nut and connector bodies into a Part. This should help integrate it with the other parts o fthe project
    [connector-mil-pt07a.FCStd]
2020-12-02 Rebuild corner bosses with manually-repeated geometry because the MultiTransform can't quite deal with the base box dimensions changing
    [enclosure-faceted3.FCStd]
2020-12-02 Added seal feature
    [enclosure-faceted3.FCStd]
2020-12-02 Add holes for inserts
    [enclosure-faceted3.FCStd]
2020-12-02 First release of the lid! Let's get some quotes
    [enclosure-faceted3.FCStd, enclosure-lid.step]
2020-12-02 Split plane defined
    [enclosure-faceted3.FCStd]
2020-12-02 Revert "Split plane defined"
    It's just too hard. Let's model the base manually
    This reverts commit 0b122d0d3e8e690dc4c2ab0a64b741e23608beee.
    [enclosure-faceted3.FCStd]
2020-12-02 Rebase cutter geometry to raise its bottom plane to be coplanar with the lid-base split plane
    [enclosure-faceted3.FCStd]
2020-12-02 Successful split - base shape exists
    [enclosure-faceted3.FCStd]
2020-12-02 Successfully split the body and made the halves into new Bodies with Part->New Body (while selecting the split part
    [enclosure-faceted3.FCStd]
2020-12-03 Add seal path
    [enclosure-faceted3.FCStd]
2020-12-03 Add the seal for the millionth time
    [enclosure-faceted3.FCStd]
2020-12-03 Base: top wall edge sketched
    [enclosure-faceted3.FCStd]
2020-12-03 Wing - slightly rough
    [enclosure-faceted3.FCStd]
2020-12-03 Add wing picture-frame hole
    [enclosure-faceted3.FCStd]
2020-12-03 Wing mirrored. Still a bit rough
    [enclosure-faceted3.FCStd]
2020-12-03 Export of the rebuilt lid with new geometry that produces the lid and base from the same parametric data by using a split plane
    [enclosure-lid.step]
2020-12-03 Add base STEP export
    [enclosure-base.step]
2020-12-04 Add some new parameters for the base. About to remodel the inside from a straight pad to a drafted loft
    [enclosure-faceted3.FCStd]
2020-12-04 Lofted out base walls. Made seal groove parametric. Model is suddenly very slow to build. Maybe because I used the 'set tip' feature to insert a sketch earlier in the history
    [enclosure-faceted3.FCStd]
2020-12-04 Base inside fillets
    [enclosure-faceted3.FCStd]
2020-12-09 Holes added to lid, most of the base geometry ready. New release for quoting
    [enclosure-base.step, enclosure-lid.step]
2021-01-04 Size 10 MIL connector
    [connector-mil-pt07a-10.FCStd]
2021-01-07 Create Part around connector Body
    [connector-mil-pt07a-10.FCStd]
2021-01-07 Add hole for connector
2021-01-08 Move connector hole
2021-01-08 Begin assembly
    [enclosure-assy.FCStd]
2021-01-08 Give connector some colour
    [connector-mil-pt07a-10.FCStd]
2021-01-10 Radius the hole for the connector
2021-01-10 Set connector and nut colour
    [connector-mil-pt07a-10.FCStd, enclosure-assy.FCStd]
2021-01-10 Add snap fit IP68 lightpipe 1282.1501 from Mentor. Requires a hole 2.6mm H7 fit
    [lightpipe-mentor-1282_1501.FCStd]
2021-01-10 Rebuild the geometry for positioning the microphone hole and associated features
2021-01-10 Holes and counterbores for light pipes
2021-01-10 Clean up geometry for positioning microphone screw bosses
2021-01-10 Mic screw boss. What a fight
2021-01-11 SIM slot - built and mirrored some bosses to accept inserts in the walls
2021-01-14 Rebuilt the basic cuboid - replace pipes with pockets, remove any reliance on 3d geometry to improve model stability. Remodelled up to the roof pitch
2021-01-15 Corners cut off, outer radii done
2021-01-15 Cut tool walls and roof
2021-01-16 Corner bosses on cut tool
2021-01-16 Cut tool SIM slot bosses
2021-01-16 Screw holes
2021-01-17 Wings mirrored, fillets added
2021-01-17 Wing fillets from parameter
2021-01-17 Rebuild wings as one piece. Loft. Define wing slots in another sketch and pocket through
2021-01-17 One PCB boss done
2021-01-18 Repair SIM door cut tool geometry. Pocket out SIM door
2021-01-18 Main PCB outline inset from the inner edge of the base wall
2021-01-18 Add PCB holes
2021-01-19 Fillets on SIM screw pillars
2021-01-19 Extend SIM door with lobes to provide thickness behind the outer edges of the door beyond the threaded inserts
2021-01-19 nanoSIM slot and card assembled into a Part
2021-01-19 microSD slot and card assembled into a Part
2021-01-20 Two separate card slots
2021-01-20 Screw head seats
2021-01-20 Screw holes, seats mirrored
2021-01-20 Lengthen whole assmbly by 15mm to accommodate the antenna. Pain!
2021-01-20 Export STEPs for Protolabs quoting
    [enclosure-base-v0.7.step, enclosure-door-v0.7.step, enclosure-lid-v0.7.step]
2021-01-20 Export STL's for 3DP quote (v0.7)
    [enclosure-door-v0.7.stl]
2021-01-20 Add mic and LED PCB's
2021-01-20 STL's as released for printing
    [enclosure-door-v0.8.stl]
2021-01-20 Add PLCC LED to LED board
2021-01-20 Full assembly as STEP
    [enclosure-assy-v0.8.step]
2021-01-25 First 3D prints didn't mate - radii on the lid's tongue were wrong. The tongue is now fixed, but it's created an undercut that needs fixing...
2021-01-30 Lid pretty much rebuilt. LED bosses in place.
2021-01-31 Base wing rebuild
2021-01-31 Base rebuilt. New approach with the wings bridged in the centre into a single solid. This permits us to do a Boolean Fuse with the Base solid and fillet afterwards
2021-01-31 Base and wings successfully filleted and fused
2021-02-01 Main PCB bosses implemented as clones. The 'odd one out' is positioned so it doesn't foul on the upper corner bos
2021-02-01 Fix boolean wing merge
2021-02-01 Main PCB bosses Fused in to the base body
2021-02-01 Adjust card slot
2021-02-01 Adjust door gasket slot
2021-02-13 Add PLCC LED
    [led-plcc.FCStd]
2021-02-13 Import main board outline and explore part placement
2021-02-13 Thumbscrew M3x8
    [P0161.030-008-B2.step]
2021-02-13 Tidy up exports folder, group by release
    [enclosure-assy-v0.8.step, enclosure-base-v0.10.step, enclosure-base-v0.7.step, enclosure-base-v0.8.step, enclosure-base-v0.9.1.step, enclosure-base-v0.9.step, enclosure-door-v0.10.step, enclosure-door-v0.10.stl]
2021-02-14 Starting to establish XY-perpendicular features on the roof (lightpipe holes, mic hole, PCB supports) so there are no undercuts. Link in PCB models
    [pcba-led.FCStd, pcba-mic.FCStd]
2021-02-15 Pull in Kicad data, position boards in the housing
    [pcba-led.FCStd, pcba-mic.FCStd]
2021-02-15 Create platform in XY plane to seat the mic board
2021-02-15 Mic mounting bosses
2021-02-15 Mic boss insert holes
2021-02-15 Move closure screws inwards 1mm, increase counterbores to 8mm dia to accept blanking plugs
2021-02-15 Add seat for acoustic membrane
    [led-plcc.FCStd, lightpipe-mentor-1282_1501.FCStd, pcba-led.FCStd, pcba-mic.FCStd]
2021-02-15 Exports for version 0.11
    [enclosure-base-v0.11.step, enclosure-door-v0.11.step, enclosure-door-v0.11.stl, enclosure-lid-v0.11.step]
2021-02-15 Exports for version 0.12 - ready for printing
    [enclosure-base-v0.12.step, enclosure-door-v0.12.step, enclosure-door-v0.12.stl, enclosure-lid-v0.12.step]
2021-02-15 Add threaded inserts to the lid
    [insert-tappex-118m3.FCStd]
2021-02-15 Add inserts to the base
2021-02-16 Core out corner bosses with some holes
2021-02-16 Further core out corners by deepening insert holes
2021-02-16 Narrow the bosses for the door inserts and thin the wall around the card slot from 2 to 1mm
2021-02-16 Deepen door insert holes to 8.5
2021-02-17 Added locating pins to base which index in the coring holes
2021-02-17 Deepen holes in base bosses, under inserts, so there shouldn't be any shrinkage on the underside of the base
2021-02-17 Add some more draft to the base screw bosses
2021-02-17 Add alignment feature to ensure the LED board is properly located over the lightpipes. With just the screw holes it's pretty sloppy. There are two 1.9mm pins mould on top of a fin-shaped boss that wi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
2021-02-19 Create new 'dogbone' style LED baffle
2021-02-19 First baffle hole
2021-02-19 Relese for indicative quote. LED boss holes missing
    [enclosure-base-v0.13.1.step, enclosure-door-v0.13.1.step, enclosure-lid-v0.13.1.step, enclosure-lid-with-inserts-v0.13.1.step]
2021-02-19 Start adding support for LED board alignment pins
2021-02-19 Add connector
2021-02-20 Extending features for screw bosses and locating pin bases to mate with PCB
2021-02-20 LED holes grooved out
2021-02-21 Screw holes for LED PCB, per Plas-Tech 30 3x8 recommendations
2021-02-21 Sync LED board edge with Kicad
    [pcba-led.FCStd]
2021-02-21 Rebuild the locating geometry for the roof features (LED screw bosses, baffle, locating pins) to fix the slight position errors. Now everything is spot on
2021-02-21 Shuffle the roof features close to their original positions. Locate LED PCB and counterbores. Locations are perfect
2021-02-21 Release 0.12 for IM quote. First release with threaded inserts in place to check effect on tool pricing
    [enclosure-base-with-inserts-v0.12.step, enclosure-lid-with-inserts-v0.12.step, enclosure-mouldings-with-inserts.step, enclosure-mouldings.step, insert-tappex-118m3.step]
2021-02-21 Release 0.13. Corners cored out to reduce shrinkage. Alignment 'fin' structure to keep LED board aligned
    [enclosure-base-v0.13.step, enclosure-base-with-inserts-v0.13.step, enclosure-door-v0.13.step, enclosure-door-v0.13.stl, enclosure-lid-v0.13.step, enclosure-lid-with-inserts-v0.13.step, insert-118m3.step]
2021-02-22 Fixed mic board platform undercut
2021-02-22 LED pins shortened and chamfered
2021-02-22 Lengthen sealing tongue to 2mm for 50% compression factor of the gasket. Groove in base has been deepened to 4mm to thin down the plastic underneath to reduce shrinkage
2021-02-22 Update LED PCB model to include locating pin holes and more radiused board outline
    [pcba-led.FCStd]
2021-02-22 File noise
    [enclosure-assy.FCStd, insert-tappex-118m3.FCStd, lightpipe-mentor-1282_1501.FCStd, pcba-mic.FCStd]
2021-02-22 File noise. Committing everything to prepare for feature merge
    [enclosure-assy.FCStd, insert-tappex-118m3.FCStd, lightpipe-mentor-1282_1501.FCStd, pcba-led.FCStd, pcba-mic.FCStd]
2021-02-22 Relink updated LED PCB model
2021-02-22 Updated PCB file
    [pcba-led.FCStd]
2021-02-22 Add MIL connector, add flat to the hole to prevent rotation
    [connector-mil-pt07a-10.FCStd]
2021-02-22 Add mating MIL connector. It's pretty huge
    [connector-mil-pt06pg-10-with-gland.FCStd]
2021-02-22 Fix pin chamfers
    [connector-mil-pt07a-10.FCStd, insert-tappex-118m3.FCStd, lightpipe-mentor-1282_1501.FCStd, pcba-mic.FCStd]
2021-02-24 Switching to M12 connector. Requires a near-vertical surface due to the much smaller o-ring. Created new geometry with 3deg draft and drafted and radiused edges.
2021-02-24 M12 connector linked in. Connector seating planes and clearances established
2021-02-24 M12 connector positioned
2021-02-24 Name/Version plate designed. Parametric entry of version number works
2021-02-24 Version plates boolean-fused into the lid and base
2021-02-24 TE M12 connectors from TE's website, with colour added
    [te-C-T4111001051-000.FCStd, te-C-T4171310005-001.FCStd]
2021-02-24 Aesthetic work - set some colours. Fix antenna position in the hierarchy.
    [connector-mil-pt06pg-10-with-gland.FCStd, connector-mil-pt07a-10.FCStd, connector-mil-pt07a.FCStd, insert-tappex-118m3.FCStd, lightpipe-mentor-1282_1501.FCStd, pcba-led.FCStd, pcba-mic.FCStd]
2021-02-24 STEP release for Protolabs quote. Possibly a release candidate, perhaps with the exception of the insert hole diameters
    [enclosure-base-v0.15.step, enclosure-door-v0.15.step, enclosure-lid-v0.15.step]
2021-02-24 STL and images for release 0.15
    [enclosure-door-v0.15.stl]
2021-02-26 Fix inverted draft on the connector face - should fix one DRC violation
2021-02-27 Raise mic horn slightly to thicken material at the base
2021-02-28 Added 0.14 and 0.15 assembly
    [enclosure-base-v0.14.step, enclosure-door-v0.14.step, enclosure-door-v0.14.stl, enclosure-lid-v0.14.step]
2021-03-11 Fix incorrect hole size for the self tappers in the lid
2021-03-11 0.16 release
    [PL_enclosure-lid-v0.16.stp, enclosure-base-v0.16.step, enclosure-door-v0.16.step, enclosure-door-v0.16.stl, enclosure-lid-v0.16.dxf, enclosure-lid-v0.16.step]
2021-03-11 1.0 release. Issued to Protolabs for manfacture, though there are two pretty nasty bugs in the lid! Zero-thickness wall next to the door recess, and incorrect screw hole shape for the self-tappers in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
    [PL_enclosure-base-v1.0.stp, PL_enclosure-door-v1.0.stl, PL_enclosure-lid-v1.0.stp, enclosure-base-v1.0.step, enclosure-door-v1.0.step, enclosure-door-v1.0.stl, enclosure-lid-v1.0.step]
2021-03-11 Full assembly for release 1.1
    [insert-tappex-118m3.FCStd, lightpipe-mentor-1282_1501.FCStd, pcba-led.FCStd, pcba-mic.FCStd, te-C-T4111001051-000.FCStd, te-C-T4171310005-001.FCStd]
2021-03-15 Add 0.5deg draft to the screw holes per Protolabs request.
2021-03-15 File noise for assembly view
    [lightpipe-mentor-1282_1501.FCStd, pcba-led.FCStd, pcba-mic.FCStd]
2021-03-15 1.2 release. Issued to Protolabs for second manufacturing run of the lid, to correct the holes in the wall and the over-size screw holes for the self-tappers
    [enclosure-base-v1.2.step, enclosure-door-v1.2.step, enclosure-lid-v1.2.step]
2021-03-18 Fix undercut problem in the connector wall. Draft was inverted on the lower half
2021-03-18 Adjust connector seat rotation to 180deg to prevent little bits poking through into the inside wall
2021-03-18 Connector wall dimensions don't match 1.0 at the region that we are trying to keep constant. First failed attempt to bring them into parity...
2021-08-03 Restructure files, add pad print data
    [P0161.030-008-B2.step, PL_enclosure-base-v1.0.stp, PL_enclosure-door-v1.0.stl, PL_enclosure-lid-v0.16.stp, PL_enclosure-lid-v1.0.stp, antenna-2JP0424.FCStd, connector-mil-pt06pg-10-with-gland.FCStd, connector-mil-pt07a-10.FCStd]
2021-08-03 v1.3 lid export as manufactured
    [enclosure-lid-v1.3.step]
2021-08-03 v1.1 exports
    [enclosure-base-v1.1.step, enclosure-door-v1.1.step, enclosure-lid-v1.1.step]
2021-08-03 M12 connectors
2021-08-03 More connectors
    [TR Fastenings Ltd-3MMX6MM.step, TR Fastenings Ltd-3mmX8mm.STEP, c-t4111001051-000-a-3d-colours.stp, c-t4111001051-000-a-3d.stp, c-t4171310005-001-a-3d-colours.stp, c-t4171310005-001-a-3d.stp, connector-mil-pt07a-8.FCStd]
2021-08-03 Remove unwanted files
    [enclosure-assy.FCStd, enclosure-base.FCStd, enclosure-base.step]
2021-08-03 Old experiments and forum discussion examples
    [enclosure-faceted-papyblaise.FCStd, enclosure-faceted2.FCStd, enclosure-faceted_cb.FCStd]
2021-08-03 tappex insert
    [insert-tappex-001m3.FCStd]
2021-08-03 Remove old experiments
    [enclosure-faceted.FCStd, enclosure-faceted2.FCStd]
2022-06-19 Increase lightpipe hole diameter.
2022-06-19 Editing in mainline FC is getting impractical - the model is just too brittle and it keeps crashing. I've installed Freecad Link Daily, which supposedly fixes the Topoloogical Naming Problem which is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
2022-06-19 Attach floating DatumPlane-sim-slot-bosses plane to the XY_Plane
2022-06-19 Attach floating DatumPlane-mic-boss-base to XY_Plane003
2022-06-19 Attach floating DatumPlane-inside-roof to BaseFeature001
2022-06-19 Fix rotation axes for the connector-seating Groove and Revolve elements
2022-06-19 Fix rotation axis for Groove-led-1-hole
2022-06-19 Fix rotation axis for Groove-led-screw
2022-06-19 Fix contraints in PCBboss-top001
2022-06-23 Fix shapebinders in enclosure-base. Bump version text to v1.4
2022-06-23 Fix shapebinder reference in enclosure-wing
2022-06-25 Move master PCB boss to one corner. Delete weird clone arrangement
2022-06-25 Move PCBboss sketches into enclosure-base body, remove Loft and clones so we can start afresh
2022-06-25 Move PCBboss sketches into enclosure-base body, including hole profile for groove
2022-06-26 Move PCB-boss geometry into separate body PCB-boss-base ready for positioning and cloning
2022-06-26 PCB boss clones created and positioned ready for boolean merge
2022-06-26 PCB bosses successfully cloned and Boolean Fused into enclosure-base body
2022-06-26 Fix broken head clearance geometry in enclosure-door
2022-06-26 Fix missing threaded inserts that weren't in the repo
    [insert-tappex-001m3.FCStd]
2022-06-26 Add missing pcb-main model that wasn't in Git. Model builds now with no errors!
    [pcba-main.FCStd]
2022-06-26 Increase hole diameter in door to 3mm
2022-06-26 Create dimensional analysis (Visual Inspection in Inspection workbench) to compare current mould tools against the new v1.4 models with the various errata solved. Annoyingly, this has highlighted a s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
    [dimensional-inspection.FCStd]
2022-06-26 Remove temporary files
    [enclosure-faceted.FCStd]
2022-06-26 Remove unnecessary files
    [TR Fastenings Ltd-3MMX6MM.step, c-t4111001051-000-a-3d.stp, c-t4171310005-001-a-3d.stp, connector-mil-pt06pg-10-with-gland.FCStd, connector-mil-pt07a-10.FCStd, connector-mil-pt07a-8.FCStd, connector-mil-pt07a.FCStd, enclosure-lid.step]
2022-06-26 Exports for version 1.4
    [enclosure-base-v1.4.step, enclosure-door-v1.4.step, enclosure-lid-v1.4.step]
2022-06-27 Recompute linked models
    [insert-tappex-001m3.FCStd, lightpipe-mentor-1282_1501.FCStd, pcba-led.FCStd, pcba-main.FCStd, pcba-mic.FCStd, screw-plastech30-3x8-TR00032288.FCStd, te-C-T4111001051-000.FCStd, te-C-T4171310005-001.FCStd]
2022-06-28 Fix broken datum plane in the connector-wall feature. The dimensional analysis caught it, but I didn't actually notice in the result, so it led to a high quote at Protolabs. This fix should result in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
    [dimensional-inspection.FCStd]
2022-06-28 Lid and base production data for v1.5 ready for quotation
    [enclosure-door-v1.5.step, enclosure-lid-v1.5.step]
2022-06-28 Fix draft angle in base corner core 1 - somehow had changed from 0.2 to 0.3mm without noticing.
    [dimensional-inspection.FCStd]
2022-06-28 Production data for base v1.5 ready for quote
    [enclosure-base-v1.5.step]
2022-12-02 Add cloned body of base part with faces coloured to indicate custom cosmetic finish on the base component.
    [pcba-led.FCStd, pcba-main.FCStd, pcba-mic.FCStd, screw-plastech30-3x8-TR00032288.FCStd, te-C-T4111001051-000.FCStd, te-C-T4171310005-001.FCStd]
2022-12-02 002M3 insert - a slightly shorter version of the Multisert 001M3. Just included for reference and experimenting with different ways of holding door screws captive.
    [insert-tappex-002m3.FCStd]
2022-12-02 Recess inserts 0.5mm below each surface to indicate to Protolabs that there should be no flashing, etc, protroding above the planes. This is particularly important if they heat-set them rather than p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
2023-01-18 Add v3 to pad printing design for proposal to graphic designer Mark McGann
2023-03-03 Housing release 1.5 including threaded insert data
    [enclosure-lid-v1.5-with-inserts.step, insert-tappex-001m3.step]
2023-03-03 Updated pad print data for V3
