bugg-resources/bugg-enclosure/(notices)

Notices in the files:
README.md:
cc-by-nc-sa-shield
